chithigun23/ANUFS-Telemetry/active_antenna_addition_BOM.md

# Active Antenna Addition — Planning Doc

Status: **implemented in schematic** (telemetry.kicad_sch), now covering two features:
1. The original single-antenna active bias-tee on J2 (below).
2. A second GNSS module + antenna (U15/J8) added purely for **heading**, via dual-antenna
   moving-base RTK — see "Dual-antenna heading addition" further down.

Library symbols/footprints for the new parts (LQW15AN56NG00D, PESD0402-140, DMG2305UX-7)
exist in telemetry-library, though the FET ended up unused — see below.

Goal, as built: dedicated active-antenna bias-tee on the existing SMA connector (J2), always
on (no switch — see "Design history" for why the switch was dropped, and why passive-antenna
compatibility is no longer a design goal: precise RTK positioning needs the active antenna's
phase-center stability and multipath rejection, so this connector is active-only going forward).

## Design history (superseded — kept for context)

Originally planned as two separate SMA connectors (existing J2 for passive, a new J601 for
active) selected by an RF switch (pSemi PE4259), so both antennas could be mounted
simultaneously with instant electronic selection. **Dropped this approach**: it only makes
sense if both antennas need to be physically connected at once.

Next iteration was a single connector supporting *either* antenna type, with bias switchable
via a FET (Q601/Q602/R602) so bias could be disabled for passive-antenna safety or power
saving. **Also dropped, for two reasons:**
1. Checked whether the module itself gates VDD_RF based on `ANT_ON` — it doesn't. VDD_RF just
   mirrors VCC always. And on this board, VCC is never power-cycled and `WAKEUP` is
   unconnected (no path to exit Backup mode), so the module never leaves Continuous mode in
   the first place — there's no power-saving event for a switch to respond to.
2. The actual goal is RTK positioning as close to 1cm as achievable. That needs the active
   antenna's phase-center stability and multipath rejection — a passive antenna is a strictly
   worse choice for this application, not a fallback worth keeping wired in. So "safely
   support either antenna type" stopped being a real requirement, and with it, the reason to
   worry about a passive antenna's DC-short fault mode on this connector went away too.

Net result: **no switch, active-only, bias always on.** `R601` (10Ω, in series with the bias
feed) still exists and still matters — it protects the module if the antenna connector is ever
shorted (e.g. a wiring fault, connector mishap), which is a real scenario worth guarding
against regardless of antenna type.

## Active antenna

**u-blox ANN-MB1-00**
- Dual-band: L1 (1559–1606 MHz) + L5/E5a/B2a/NavIC (1164–1188 MHz) — matches LC29H(EA)'s
  dual-band capability
- Bias: 3.0–5.0 V, typ. 15 mA @ 5V (VDD_RF on this board mirrors VCC = 3.3V, within spec)
- LNA gain: typ. 29 dB (L1) / 33 dB (L5), pre-filtered with an internal SAW
- 5 m RG174 cable, SMA connector, magnetic mount
- IP67, –40°C to +85°C, CE approved
- Source: [DigiKey](https://www.digikey.com/en/products/detail/u-blox/ANN-MB1-00/14835875)
- Datasheet: [ANN-MB1 Product Summary](https://content.u-blox.com/sites/default/files/ANN-MB1_ProductSummary_UBX-21000238.pdf)

## Topology (as built)

Follows Quectel's own active-antenna reference circuit (Hardware Design doc, Sheet 6), minus
the optional power switch. `VDD_RF → R40 → [C36, C38 decoupling] → L2 → antenna node [D2 TVS,
J2, C40 DC-block] → RF_IN`. Bias is always on.

| Schematic ref | Part | Value/Footprint | Connects |
|---|---|---|---|
| R40 | 10Ω | [Resistor_SMD:R_0402_1005Metric_Pad0.72x0.64mm_HandSolder](.) | VDD_RF (pin 9) → bias choke; limits fault current if the connector is ever shorted |
| C36 | Yageo CC0402KRX7R7BB104, 100nF, X7R | [LCSC C60474](https://www.lcsc.com/product-detail/C60474.html), 16V, ±10%, $0.005 (100+ qty) | Decouple, on bias line near L2 — shunt-to-ground, dielectric loss doesn't matter here |
| C38 | Yageo CC0402JRNPO9BN101, 100pF, C0G/NP0 | [LCSC C106200](https://www.lcsc.com/product-detail/Multilayer-Ceramic-Capacitors-MLCC-SMD-SMT_YAGEO-CC0402JRNPO9BN101_C106200.html), 50V, ±5%, $0.0044 (100+ qty) | Decouple, on bias line near L2 |
| L2 | Murata LQW15AN56NG00D, 56nH | telemetry:LQW15AN56NG00D, [DigiKey 490-6830-1-ND](https://www.digikey.com/en/products/detail/murata-electronics/LQW15AN56NG00D/3846027) | Feeds DC bias onto the RF_IN line without loading the RF signal. SRF 2.8GHz (56% margin above L1's 1575.42MHz — chosen over Quectel's literal 68nH spec, which only has ~3% SRF margin on any commonly available part), 200mA rating, $0.12 |
| D2 | Littelfuse PESD0402-140 | telemetry:PESD0402-140, [DigiKey PESD0402-140CT-ND](https://www.digikey.com/en/products/detail/littelfuse-inc/PESD0402-140/1968525) | ESD protection at the antenna node. 0.05pF (well under Quectel's <0.6pF recommendation), 14V standoff (clear of the 3.3V bias), $0.80 |
| C40 | Yageo CC0402JRNPO9BN101, 100pF, C0G/NP0 | [LCSC C106200](https://www.lcsc.com/product-detail/Multilayer-Ceramic-Capacitors-MLCC-SMD-SMT_YAGEO-CC0402JRNPO9BN101_C106200.html), 50V, ±5%, $0.0044 (100+ qty) | DC block between the antenna node and RF_IN (pin 11) — C0G/NP0 specifically chosen since this cap sits directly in the RF signal path (X7R's higher dielectric loss would add real insertion loss here, unlike C36 which is just a shunt bypass) |
| J2 | (existing) | — | Antenna connector, SMA |

**Dielectric note:** C38 and C40 use the *same* C0G/NP0 part (LCSC C106200) even though C38 is just a decoupling cap that didn't strictly need C0G — no cost or sourcing penalty at this value, and it simplifies the BOM to one fewer distinct part. C36 stays X7R since 100nF isn't practically available in C0G at 0402 size, and it doesn't matter for a shunt-to-ground bypass cap anyway.

**Note:** `R40`'s footprint was originally set to `Resistor_THT:R_Array_SIP4` (wrong package,
clearly a leftover default) and `C36`/`C38`/`C40` had no footprint at all — all four fixed
directly in the schematic (2026-09-18).

**Sourcing note:** AEC-Q200 was not treated as a requirement when picking L2/D2 —
for a Formula Student car (rebuilt/inspected each season, not a 10+ year OEM warranty part),
the real drivers are electrical fit and physical robustness (temp range, small rigid SMD
construction), not automotive PPAP qualification. Both parts are confirmed direct
DigiKey stock, not DigiKey Marketplace listings.

**Not used: Diodes Inc DMG2305UX-7 P-FET.** A symbol/footprint (`telemetry:DMG2305UX-7`)
exists in the library from when a bias switch was still planned, but the switch was dropped
(see Design history) before it got used anywhere in the schematic. The board does have an
unrelated `Q1` (DMP3099LQ-7) and `Q2` (MMBT3904) — those belong to a separate 12V input
protection circuit, not this antenna feature; don't confuse the two when reading the BOM.

## Dual-antenna heading addition (U15/J8) — implemented in schematic

**Why:** the AUSCORS/CORSnet-NSW network corrections (free, via Geoscience Australia's
Positioning Australia program) improve absolute *position* accuracy, but say nothing about
which way the car is pointing. A single antenna's only heading signal is course-over-ground
(the direction of the velocity vector), which is meaningless at low speed or standstill. True,
speed-independent heading needs a second antenna at a fixed, known separation, computed via
moving-base RTK between two receivers — a completely separate feature from the network RTK
corrections, not a replacement for them. Both can be used at once if wanted.

**Roles:**
- **U13 (existing module) = Rover.** Unchanged — still talks to the MCU exactly as before
  (UART1 → level shifter U14 → STM32 **UART4**, AF8, on PA0/PA1). It's the one that outputs
  the final position/heading solution.
- **U15 (new module) = Base.** Only generates the raw observation stream for U13 to compute
  the baseline/heading against. Does **not** talk to the MCU at all — U15's own UART1
  (TXD1/RXD1) and 1PPS (pin 3) are intentionally NC-flagged, unused.

**Module-to-module link (UART2 on both modules, full crossover, no level shifting needed —
both run off their own internally-generated VDD_EXT at the same logic level):**
| From | To | Net |
|---|---|---|
| U15 (Base) TXD2, pin 15 | U13 (Rover) RXD2, pin 16 | `TXD2_GNSS_2V8_2` |
| U13 (Rover) TXD2, pin 15 | U15 (Base) RXD2, pin 16 | `RXD2_GNSS_2V8_2` |

**Second bias-tee (U15), identical topology to J2's, same parts reused:**
`VDD_RF (U15 pin 9) → R41 → [C41, C43 decoupling] → L3 → antenna node [D5 TVS, J8, C42
DC-block] → RF_IN (U15 pin 11)`

| Schematic ref | Part | Value/Footprint | Connects |
|---|---|---|---|
| R41 | 10Ω | Resistor_SMD:R_0402_1005Metric_Pad0.72x0.64mm_HandSolder | VDD_RF → bias choke, same fault-current role as R40 |
| C41 | Yageo, 100pF, C0G/NP0 | [LCSC C106200](https://www.lcsc.com/product-detail/Multilayer-Ceramic-Capacitors-MLCC-SMD-SMT_YAGEO-CC0402JRNPO9BN101_C106200.html) | Decouple, bias line near L3 |
| C43 | Yageo CC0402KRX7R7BB104, 100nF, X7R | [LCSC C60474](https://www.lcsc.com/product-detail/C60474.html) | Decouple, bias line near L3 |
| L3 | Murata LQW15AN56NG00D, 56nH | telemetry:LQW15AN56NG00D, [DigiKey 490-6830-1-ND](https://www.digikey.com/en/products/detail/murata-electronics/LQW15AN56NG00D/3846027) | Same SRF-margin choke as L2 |
| D5 | Littelfuse PESD0402-140 | telemetry:PESD0402-140, [DigiKey PESD0402-140CT-ND](https://www.digikey.com/en/products/detail/littelfuse-inc/PESD0402-140/1968525) | ESD protection at antenna node |
| C42 | Yageo CC0402JRNPO9BN101, 100pF, C0G/NP0 | [LCSC C106200](https://www.lcsc.com/product-detail/Multilayer-Ceramic-Capacitors-MLCC-SMD-SMT_YAGEO-CC0402JRNPO9BN101_C106200.html) | DC block, antenna node → RF_IN |
| J8 | GCT RFPC-SMA27-F | telemetry:RFPC-SMA27-F, [DigiKey 22162144](https://www.digikey.com/en/products/detail/gct/RFPC-SMA27-F/22162144), right-angle THT SMA jack, 6GHz, ~$2.26 — same part as J2. **Currently backorder/out of stock at DigiKey**, worth checking before final BOM lock | Second antenna connector |

All of R41/C41/C43/L3/D5/C42 are the exact same MPNs as R40/C36/C38/L2/D2/C40 (module 1) —
just a second set, no new sourcing decisions needed for those. J8 is the only genuinely new
line item.

**D_SEL pull-ups (U15):** R42 (39kΩ, DSEL2 → `VDD_EXT_2`) and R43 (39kΩ, DSEL1 → `VDD_EXT_2`)
— same 39kΩ-to-VDD_EXT strapping as U13's R38/R39, giving D_SEL=(1,0)=SPI... actually giving
whatever mode U13 uses; set to match U13's strap so both modules are configured identically.

**Level shifter U16 — added, then removed.** Originally duplicated U14 alongside U15 to give
it its own MCU-facing level-shifted UART1, but that's unnecessary: U15 never talks to the MCU
in this design, so there's nothing for a second level shifter to shift. Removed, along with
its supporting R46/C44 (which existed to support U16 specifically, same as R35/C23 support
U14 — not independent parts, correctly deleted together).

**Shared reset:** U13 and U15 are tied to the same `GNSS_RESET_N` net — both modules reset
together off one MCU line. Intentional/simplest choice; revisit only if independent resets
are ever needed (e.g. power-cycling just the Base without disturbing the Rover).

**Second antenna:** same u-blox ANN-MB1-00 as the first (see "Active antenna" section above)
— need **two** of this part now, not one. Minimum antenna separation for reliable RTK-Fixed
heading is realistically ~30cm+ (Quectel's documented minimum is 0.2m, but field reports
suggest 27cm baselines only reach RTK-Float, not Fixed) — mounting separation on the car needs
to account for this.

**Firmware TODO (not yet done, flagging so it isn't forgotten):**
- Configure U15 (Base) to output raw observation data on UART2 (moving-base mode).
- Configure U13 (Rover) to accept corrections on UART2 and enable `PQTMTAR` output
  (baseline distance + heading) at a sane rate — 10Hz has been reported to give worse
  RTK-Fixed stability than 1–5Hz in the field, worth testing both.
- STM32 side is unchanged — still just UART4 (AF8) on PA0/PA1 reading U13's NMEA/PQTM output,
  exactly as the single-antenna design already required.

## Bandpass filtering — decided against, not implementing

Considered adding a board-level bandpass filter for automotive EMI robustness (Quectel's
reference design marks this optional). **Decision: not using an external bandpass filter.**
The single-connector switchable-bias feature above stands on its own without it.

Research is kept below for reference in case this gets revisited later — e.g. if EMI proves
to be a real problem once the car is running and generating RF noise on track.

<details>
<summary>Bandpass filter research (not currently planned)</summary>

LC29H(EA) has a single dual-band `RF_IN` pin (no separate L1/L2 inputs), so what would be
needed is a filter that passes *both* L1 and L5 on one line while rejecting everything else.

**Rejected option — Taoglas DXP.02.A SAW diplexer used as a combiner.** Considered splitting
the antenna signal 2 ways, feeding one leg into the diplexer's L1 port and the other into its
L2/L5 port, and taking the recombined signal off Common. **Do not use this** — a diplexer's
ports are only 50Ω-matched *within that port's own passband*; band separation works by
reflecting out-of-band energy, not absorbing it. Feeding a dual-band signal into a single-band
port means the other band's energy hits an uncharacterized, reflective mismatch at that port.
Combined with ~3dB splitter loss and ~4dB diplexer loss, this is not a clean 50Ω system.

**If revisited, use instead — Abracon AFII-LC-0081 full-band GNSS ceramic bandpass filter:**
- Genuine 2-port device (Input/Output), not a diplexer
- 50Ω source and load impedance, both ports — datasheet states "a matching network is
  unnecessary." VSWR 1.2 typ / 1.5 max across the entire 1125–1675 MHz passband, so both L1
  and L5 sit cleanly inside one continuous, well-matched band
- Insertion loss: 0.85dB typ / 1.9dB max
- Rejection: 40dB below 900MHz, 25dB at 900-1002MHz, 35dB at 2-2.5GHz, 27dB at 2.5-5.95GHz
- Has internal DC-blocking caps on both input/output — would need to sit upstream of the
  bias-injection point on the active leg
- 3.2×2.5×1.75mm SMD, -45°C to +85°C, MSL1, automotive-validated COTS per Abracon's datasheet
- ~$0.76. [DigiKey (AFII-LC-0081-T)](https://www.digikey.com/en/products/detail/abracon-llc/AFII-LC-0081-T/) · [Datasheet](https://abracon.com/datasheets/AFII-LC-0081.pdf)

</details>
