chithigun23/ANUFS-Telemetry/hardware/TELEMETRY_DigiKey_BOM.xlsx

Sheet: BOM
# | Reference(s) | Qty | Value | Package / Footprint | Manufacturer | Manufacturer Part Number (MPN) | DigiKey Part Number | Purchasing spec / action | Notes
1 | C1,C14,C19-C21,C24-C26,C32-C37,C43,C46 | 16 | 100nF | C_0402_1005Metric_Pad0.74x0.62mm_HandSolder |  |  |  | Select exact supplier part matching value and footprint.
2 | C2,C11-C13,C17,C41,C44,C47,C53 | 9 | 1uF | C_0402_1005Metric_Pad0.74x0.62mm_HandSolder |  |  |  | Select exact supplier part matching value and footprint.
3 | C3 | 1 | 220nF | C_0402_1005Metric_Pad0.74x0.62mm_HandSolder |  |  |  | Select exact supplier part matching value and footprint.
4 | C4,C10,C38-C40,C42,C45 | 7 | 10uF | C_0402_1005Metric_Pad0.74x0.62mm_HandSolder |  |  |  | Select exact supplier part matching value and footprint.
5 | C5,C7-C9,C18 | 5 | 22uF | C_0402_1005Metric_Pad0.74x0.62mm_HandSolder |  |  |  | Select exact supplier part matching value and footprint.
6 | C6 | 1 | 100uF | CP_Elec_6.3x7.7 |  |  |  | Select exact supplier part matching value and footprint.
7 | C15,C16 | 2 | 8pF | C_0402_1005Metric_Pad0.74x0.62mm_HandSolder |  |  |  | Select exact supplier part matching value and footprint.
8 | C22,C23 | 2 | 2.2uF | C_0402_1005Metric_Pad0.74x0.62mm_HandSolder |  |  |  | Select exact supplier part matching value and footprint.
9 | C27,C30,C48,C51 | 4 | 100pF | C_0402_1005Metric_Pad0.74x0.62mm_HandSolder | Yageo | CC0402JRNPO9BN101 |  | Match package and ordering suffix. | LCSC: C106200. C0G/NP0, 50V, 5%. GNSS antenna bias-tee DC block or bias decoupling cap (source: active_antenna_addition_BOM.md).
10 | C31,C52 | 2 | 100nF | C_0402_1005Metric_Pad0.74x0.62mm_HandSolder | Yageo | CC0402KRX7R7BB104 |  | Match package and ordering suffix. | LCSC: C60474. X7R, 16V, 10%. GNSS antenna bias-tee decoupling cap (source: active_antenna_addition_BOM.md).
11 | D1 | 1 | BZT52-C15S-AU_R1_000A1 | D_SOD-123 |  | BZT52-C15S-AU_R1_000A1 |  | Match package and ordering suffix. | Part identifier from schematic value; verify exact ordering code.
12 | D2 | 1 | SMBJ16A | SMBJ16A | Littelfuse | SMBJ16A |  | Match package and ordering suffix. | LCSC: C151254
13 | D3 | 1 | PMEG2010BER | Nexperia_CFP3_SOD-123W |  | PMEG2010BER |  | Match package and ordering suffix. | Part identifier from schematic value; verify exact ordering code.
14 | D4,D5 | 2 | PESD0402-140 | PESD0402-140 | Littelfuse | PESD0402-140 | PESD0402-140CT-ND | Match package and ordering suffix. | LCSC: C10662. ESD protection at the GNSS antenna node.
15 | F1 | 1 | 1.5A Polyfuse | L_1812_4532Metric_Pad1.30x3.40mm_HandSolder |  |  |  | Select exact supplier part matching value and footprint.
16 | J1,J4,J5 | 3 | 2601-1102 | WAGO-2601-1102 |  |  |  | Select exact supplier part matching value and footprint.
17 | J3,J11 | 2 | MOLEX_104031-0811 | MOLEX_104031-0811 |  |  |  | Select exact supplier part matching value and footprint.
18 | J6 | 1 | USB_C_Receptacle_USB2.0_16P | USB-C-SMD_TYPE-C-16PIN-2MD-073 |  |  |  | Select exact supplier part matching value and footprint. | LCSC: C2765186
19 | J7-J10 | 4 | RFPC-SMA27-F | RFPC-SMA27-F | GradConn | RFPC-SMA27-F |  | Match package and ordering suffix. | J7 and J8 are the GNSS antenna inputs. J9 and J10 are joined to each other on net ANT3 (RF test through-path). active_antenna_addition_BOM.md lists this part as GCT, DigiKey 22162144, and flags it as backorder: check stock before ordering.
20 | L1 | 1 | 8uH, 14m | L_TaiTech_TMPC1265_13.5x12.5mm |  |  |  | Select exact supplier part matching value and footprint.
21 | L2,L3 | 2 | LQW15AN56NG00D | LQW15AN56NG00D | Murata | LQW15AN56NG00D | 490-6830-1-ND | Match package and ordering suffix. | LCSC: C167482. 56nH GNSS antenna bias choke, SRF 2.8GHz (source: active_antenna_addition_BOM.md).
22 | LED1-LED5 | 5 | XL-2012SURUGC | XL-2012SURUGC | XINGLIGHT(成兴光) | XL-2012SURUGC |  | Match package and ordering suffix. | LCSC: C965845
23 | Q1 | 1 | DMP3099LQ-7 | SOT-23 |  | DMP3099LQ-7 |  | Match package and ordering suffix. | Part identifier from schematic value; verify exact ordering code.
24 | Q2 | 1 | MMBT3904 | SOT-23 |  | MMBT3904 |  | Match package and ordering suffix. | Part identifier from schematic value; verify exact ordering code.
25 | R1 | 1 | 23.7k | R_0402_1005Metric_Pad0.72x0.64mm_HandSolder |  |  |  | Select exact supplier part matching value and footprint.
26 | R2 | 1 | 18.2k | R_0402_1005Metric_Pad0.72x0.64mm_HandSolder |  |  |  | Select exact supplier part matching value and footprint.
27 | R3 | 1 | 21.5k | R_0402_1005Metric_Pad0.72x0.64mm_HandSolder |  |  |  | Select exact supplier part matching value and footprint.
28 | R4,R38 | 2 | 100k | R_0402_1005Metric_Pad0.72x0.64mm_HandSolder |  |  |  | Select exact supplier part matching value and footprint.
29 | R5,R6,R11,R12 | 4 | 5k | R_0402_1005Metric_Pad0.72x0.64mm_HandSolder |  |  |  | Select exact supplier part matching value and footprint.
30 | R7,R13-R23,R26-R29,R34,R36,R37,R46-R52 | 26 | 10k | R_0402_1005Metric_Pad0.72x0.64mm_HandSolder |  |  |  | Select exact supplier part matching value and footprint.
31 | R8 | 1 | 43.2k | R_0402_1005Metric_Pad0.72x0.64mm_HandSolder |  |  |  | Select exact supplier part matching value and footprint.
32 | R9 | 1 | 10.2k | R_0402_1005Metric_Pad0.72x0.64mm_HandSolder |  |  |  | Select exact supplier part matching value and footprint.
33 | R10 | 1 | 73.2k | R_0402_1005Metric_Pad0.72x0.64mm_HandSolder |  |  |  | Select exact supplier part matching value and footprint. | 73.2k sets the TPS2121 OV1 trip. Trip = VREF x (1 + R10/R12) with VREF 1.01/1.06/1.10 V (min/typ/max, TPS2121 datasheet) and R12 = 5k: 15.8/16.6/17.2 V, above the ~14 V vehicle supply maximum (TEL-28).
34 | R24,R25 | 2 | 4.7k | R_0402_1005Metric_Pad0.72x0.64mm_HandSolder |  |  |  | Select exact supplier part matching value and footprint.
35 | R30,R31 | 2 | 1.87k | R_0402_1005Metric_Pad0.72x0.64mm_HandSolder |  |  |  | Select exact supplier part matching value and footprint.
36 | R32,R33 | 2 | 5.1k | R_0402_1005Metric_Pad0.72x0.64mm_HandSolder |  |  |  | Select exact supplier part matching value and footprint.
37 | R35,R42 | 2 | 0 | R_0402_1005Metric_Pad0.72x0.64mm_HandSolder |  |  |  | Select exact supplier part matching value and footprint. | 0 ohm link in the RF pi-filter series position, populated.
38 | R39,R43 | 2 | 10 | R_0402_1005Metric_Pad0.72x0.64mm_HandSolder |  |  |  | Select exact supplier part matching value and footprint. | GNSS antenna bias series resistor, limits fault current if the antenna connector is shorted (source: active_antenna_addition_BOM.md).
39 | SW1,SW2 | 2 | CJS-1200TB1 | CJS-1200TB1 | Nidec Components | CJS-1200TB1 |  | Match package and ordering suffix. | LCSC: C2921631
40 | SW3 | 1 | SW_NRST | SMD-Switch |  |  |  | Select exact supplier part matching value and footprint.
41 | SW4 | 1 | SW_BOOT0 | SMD-Switch |  |  |  | Select exact supplier part matching value and footprint.
42 | TP1 | 1 | VBUS | TestPoint_THTPad_D2.0mm_Drill1.0mm |  |  |  | Optional physical test point; select matching footprint.
43 | TP2 | 1 | +3V3 | TestPoint_THTPad_D2.0mm_Drill1.0mm |  |  |  | Optional physical test point; select matching footprint.
44 | TP3 | 1 | PG_BUCK | TestPoint_THTPad_D2.0mm_Drill1.0mm |  |  |  | Optional physical test point; select matching footprint.
45 | TP4 | 1 | GND | TestPoint_THTPad_D2.0mm_Drill1.0mm |  |  |  | Optional physical test point; select matching footprint.
46 | TP5 | 1 | CAN1+ | TestPoint_THTPad_D2.0mm_Drill1.0mm |  |  |  | Optional physical test point; select matching footprint.
47 | TP6 | 1 | CAN1- | TestPoint_THTPad_D2.0mm_Drill1.0mm |  |  |  | Optional physical test point; select matching footprint.
48 | TP7 | 1 | CAN2+ | TestPoint_THTPad_D2.0mm_Drill1.0mm |  |  |  | Optional physical test point; select matching footprint.
49 | TP8 | 1 | CAN2- | TestPoint_THTPad_D2.0mm_Drill1.0mm |  |  |  | Optional physical test point; select matching footprint.
50 | U1 | 1 | LMR33610ADDAR | Texas_HSOP-8-1EP_3.9x4.9mm_P1.27mm_ThermalVias |  | LMR33610ADDAR |  | Match package and ordering suffix. | Part identifier from schematic value; verify exact ordering code.
51 | U2 | 1 | TPS2121RUXR | VQFN-HR-12_L2.5-W2.0-P0.50-BL | TI(德州仪器) | TPS2121RUXR |  | Match package and ordering suffix. | LCSC: C485916
52 | U3 | 1 | ASM330LHHXG1TR | ASM330LHHXG1TR |  | ASM330LHHXG1TR |  | Match package and ordering suffix. | PCB value now matches the schematic (ASM330LHHXG1TR).
53 | U4,U7 | 2 | TCAN337 | SOIC-8_3.9x4.9mm_P1.27mm |  | TCAN337 |  | Match package and ordering suffix. | Part identifier from schematic value; verify exact ordering code.
54 | U5 | 1 | LM2940CT-5.0/LF01 | TO-263-3_TabPin2 (SMD formed-lead, TI NDG) | Texas Instruments | LM2940CT-5.0/LF01 |  | Match package and ordering suffix. | Confirmed SMD formed-lead variant (TI package code NDG) -- entire part incl. tab solders flat to the board, no through-hole leads and no mounting screw. Do not substitute the standard through-hole TO-220 LM2940CT-5.0/NOPB.
55 | U6 | 1 | STM32H523RCT7 | STM32H523RCT7 |  | STM32H523RCT7 |  | Match package and ordering suffix. | Part identifier from schematic value; verify exact ordering code.
56 | U8,U9 | 2 | TLC59108IPWR | TLC59108IPWR | Texas Instruments | TLC59108IPWR |  | Match package and ordering suffix.
57 | U10,U13 | 2 | LC29HEAMD | LC29HEAMD | Quectel | LC29HEAMD |  | Match package and ordering suffix. | U10 is the moving base (talks to the MCU), U13 is the rover. Part identifier from schematic value; verify exact ordering code.
58 | U11 | 1 | USBLC6-2SC6 | SOT-23-6 |  | USBLC6-2SC6 |  | Match package and ordering suffix. | Part identifier from schematic value; verify exact ordering code.
59 | U12 | 1 | TXS0104EPW | TSSOP-14_4.4x5mm_P0.65mm |  | TXS0104EPW |  | Match package and ordering suffix. | Part identifier from schematic value; verify exact ordering code.
60 | Y1 | 1 | ABM8AIG-24.000MHz-8-2Z-T | ABM8AIG-24.000MHZ-8-2Z-T | Abracon | ABM8AIG-24.000MHz-8-2Z-T |  | Match package and ordering suffix. | Part identifier from schematic value; verify exact ordering code.
 | TOTAL PLACEMENTS
 | NOT PURCHASED: DNP or excluded from BOM (listed for reference, not in the total above)
 | C28,C29,C49,C50 | 4 | 0 | C_0402_1005Metric_Pad0.74x0.62mm_HandSolder |  |  |  | Do not order. | DNP: RF pi-filter shunt pad, intentionally left empty (tuning allowance)
 | H1-H4 | 4 | MountingHole_Pad | MountingHole_3.2mm_M3_Pad |  |  |  | Do not order. | Mounting hole, not purchased
 | J2 | 1 | TC2030 | Tag-Connect_TC2030-IDC-FP_2x03_P1.27mm_Vertical |  |  |  | Do not order. | Tag-Connect TC2030 footprint only, no part to buy (excluded from BOM in schematic)
 | J12 | 1 | Conn_01x04 | PinHeader_1x04_P2.54mm_Vertical |  |  |  | Do not order. | DNP: alternative 1x4 SWD header, only one of J2 / J12 is ever fitted (excluded from BOM in schematic)

Sheet: Cautions
Item | Severity | What it is | What to do before / when ordering
R10 (TEL-28) | CHECK | TPS2121 OV1 divider R10/R12 sets the vehicle-input overvoltage trip. With R10 = 73.2k and R12 = 5k the trip is 15.8/16.6/17.2 V (min/typ/max, VREF 1.01/1.06/1.10 V). | Fit 73.2k at R10, matching the schematic and PCB (a 1% part keeps the trip window tight). An older BOM carried a lower value that trips inside the vehicle supply range, so do not reuse parts bought from it.
Supplier selection | TO COMPLETE | Rows without an exact MPN require part selection. | Use the value, footprint and listed specifications. Blank DigiKey numbers have not been sourced.
DigiKey Upload | SCOPE | Only explicit schematic MPNs and non-inferred existing BOM MPNs are included. | Resolve rows with missing or inferred part numbers on the BOM before adding them to an order.
Quantity basis | INFO | 149 BOM-included board items; one board. | Excludes: H1, H2, H3, H4, J2, J12 (excluded from BOM in the schematic) and C28, C29, C49, C50 (DNP RF pad positions, intentionally empty). Optional test points and bare wire pads may not require purchased parts.
Source | INFO | hardware/telemetry.net exported 2026-10-13 (Eeschema 10.0.6), matching schematic and PCB. | Quantities and footprints use the netlist. Part metadata uses the schematic fields, with antenna-circuit parts from active_antenna_addition_BOM.md.

Sheet: DigiKey Upload
Manufacturer Part Number | Quantity | Customer Reference
SMBJ16A | 1 | D2
XL-2012SURUGC | 5 | LED1-LED5
CJS-1200TB1 | 2 | SW1,SW2
TPS2121RUXR | 1 | U2
LM2940CT-5.0/LF01 | 1 | U5
TLC59108IPWR | 2 | U8,U9
LQW15AN56NG00D | 2 | L2,L3
PESD0402-140 | 2 | D4,D5
Only source-specified MPNs are listed. Complete missing or inferred part numbers on the BOM before ordering.
