chithigun23/ANUFS-Telemetry/telemetry-library/3d/ASM330LHHXG1TR.step

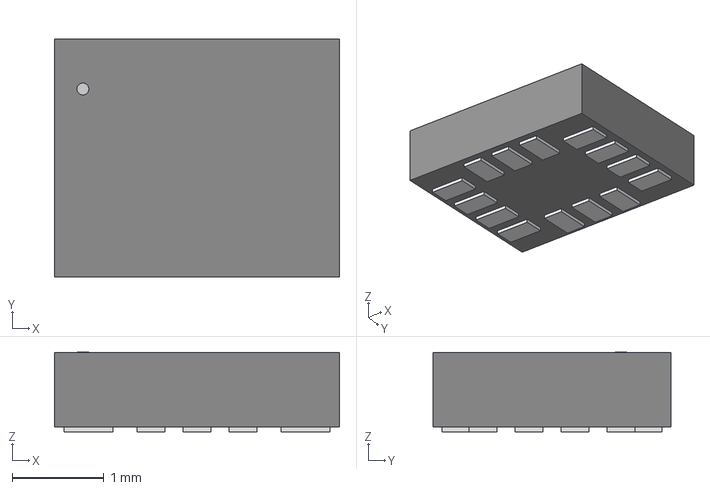
[picture p1: CAD file, 2026-08-07]
telemetry-library/3d/ASM330LHHXG1TR.step
3.10 x 2.59 x 0.866 mm
