chithigun23/ANUFS-Telemetry/telemetry-kicad/telemetry-library/3d/SD_Yamaichi_FPS009-4200-0.step

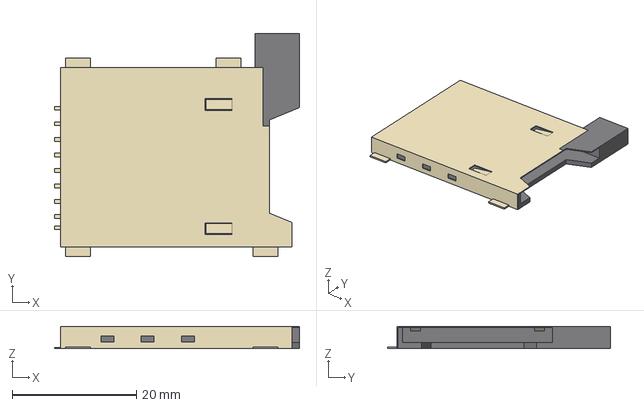
[picture p2: CAD file, 2026-09-14]
telemetry-kicad/telemetry-library/3d/SD_Yamaichi_FPS009-4200-0.step
39.5 x 35.9 x 3.60 mm
