chithigun23/ANUFS-Telemetry/telemetry-library/3d/SMD-Switch.step

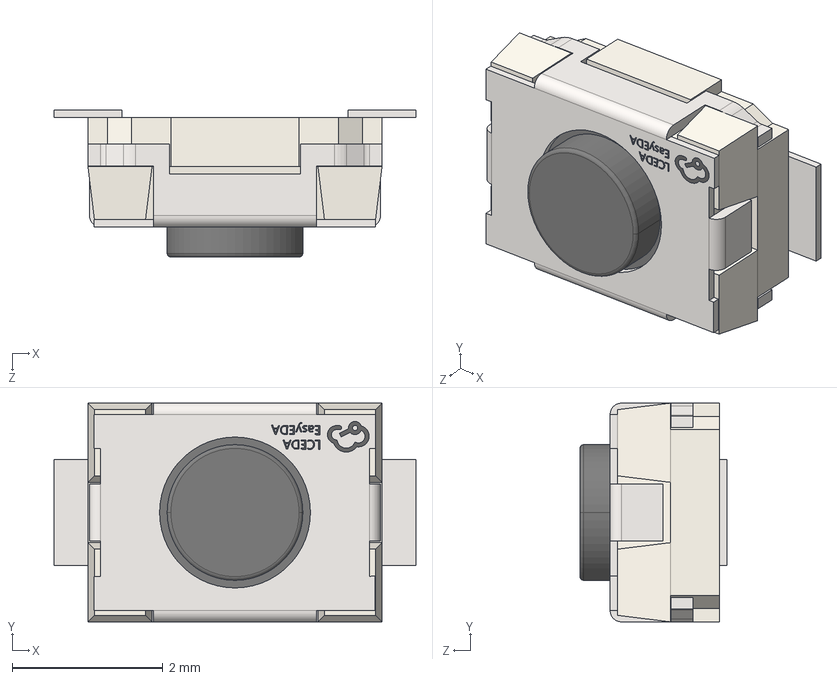
[picture p3: CAD file, 2026-08-09]
telemetry-library/3d/SMD-Switch.step
4.80 x 2.90 x 1.95 mm
