chithigun23/ANUFS-Telemetry/telemetry-kicad/telemetry-library/3d/MOLEX_104031-0811.stp

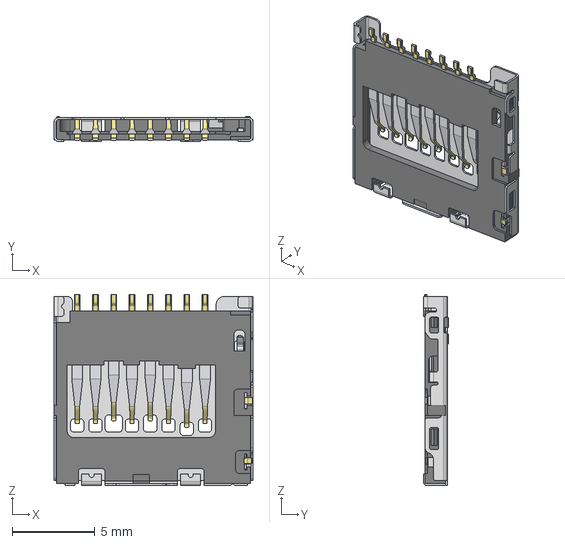
[picture p4: CAD file, 2026-09-14]
telemetry-kicad/telemetry-library/3d/MOLEX_104031-0811.stp
12.0 x 1.53 x 11.5 mm
