chithigun23/ANUFS-Telemetry/telemetry-library/3d/TCAN1044VDRQ1.stp

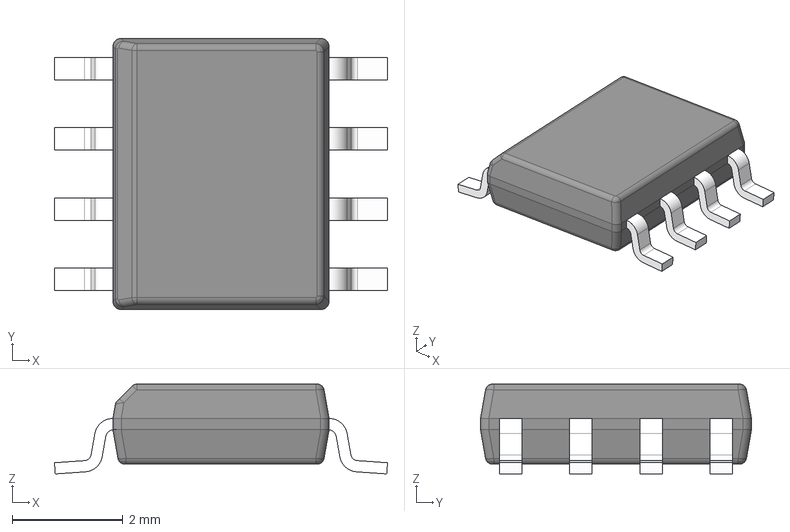
[picture p5: CAD file, 2026-08-07]
telemetry-library/3d/TCAN1044VDRQ1.stp
6.02 x 4.90 x 1.63 mm
BODY-SO
LEAD-D0008A x 8
