chithigun23/ANUFS-Telemetry/telemetry-kicad/telemetry-library/3d/STM32H523RCT7.step

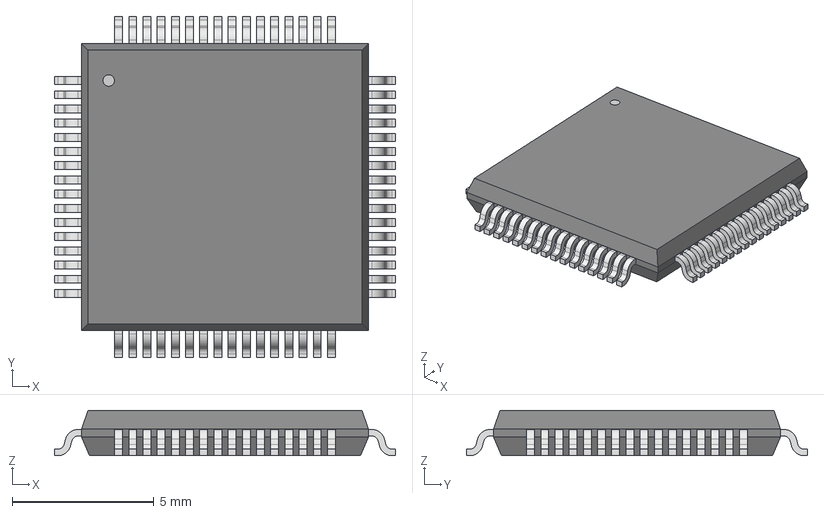
[picture p6: CAD file, 2026-08-09]
telemetry-kicad/telemetry-library/3d/STM32H523RCT7.step
12.0 x 12.0 x 1.60 mm
