chithigun23/ANUFS-Telemetry/telemetry-library/3d/MAX-M10S-00B.step

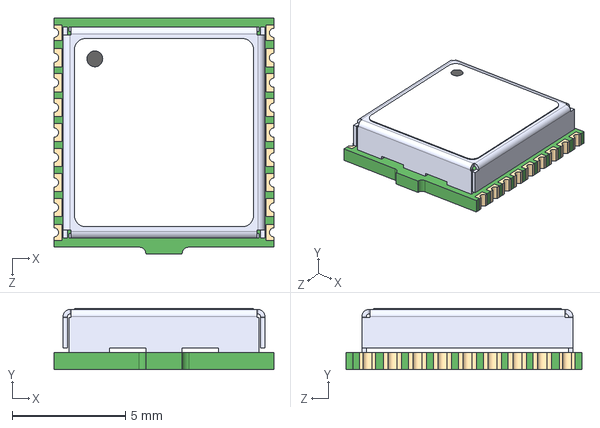
[picture p7: CAD file, 2026-08-06]
telemetry-library/3d/MAX-M10S-00B.step
9.70 x 2.70 x 10.4 mm
