chithigun23/ANUFS-Telemetry/hardware/telemetry-kicad/telemetry.kicad_pcb

## KiCad design hardware/telemetry-kicad/telemetry.kicad_pcb (2026-10-27)

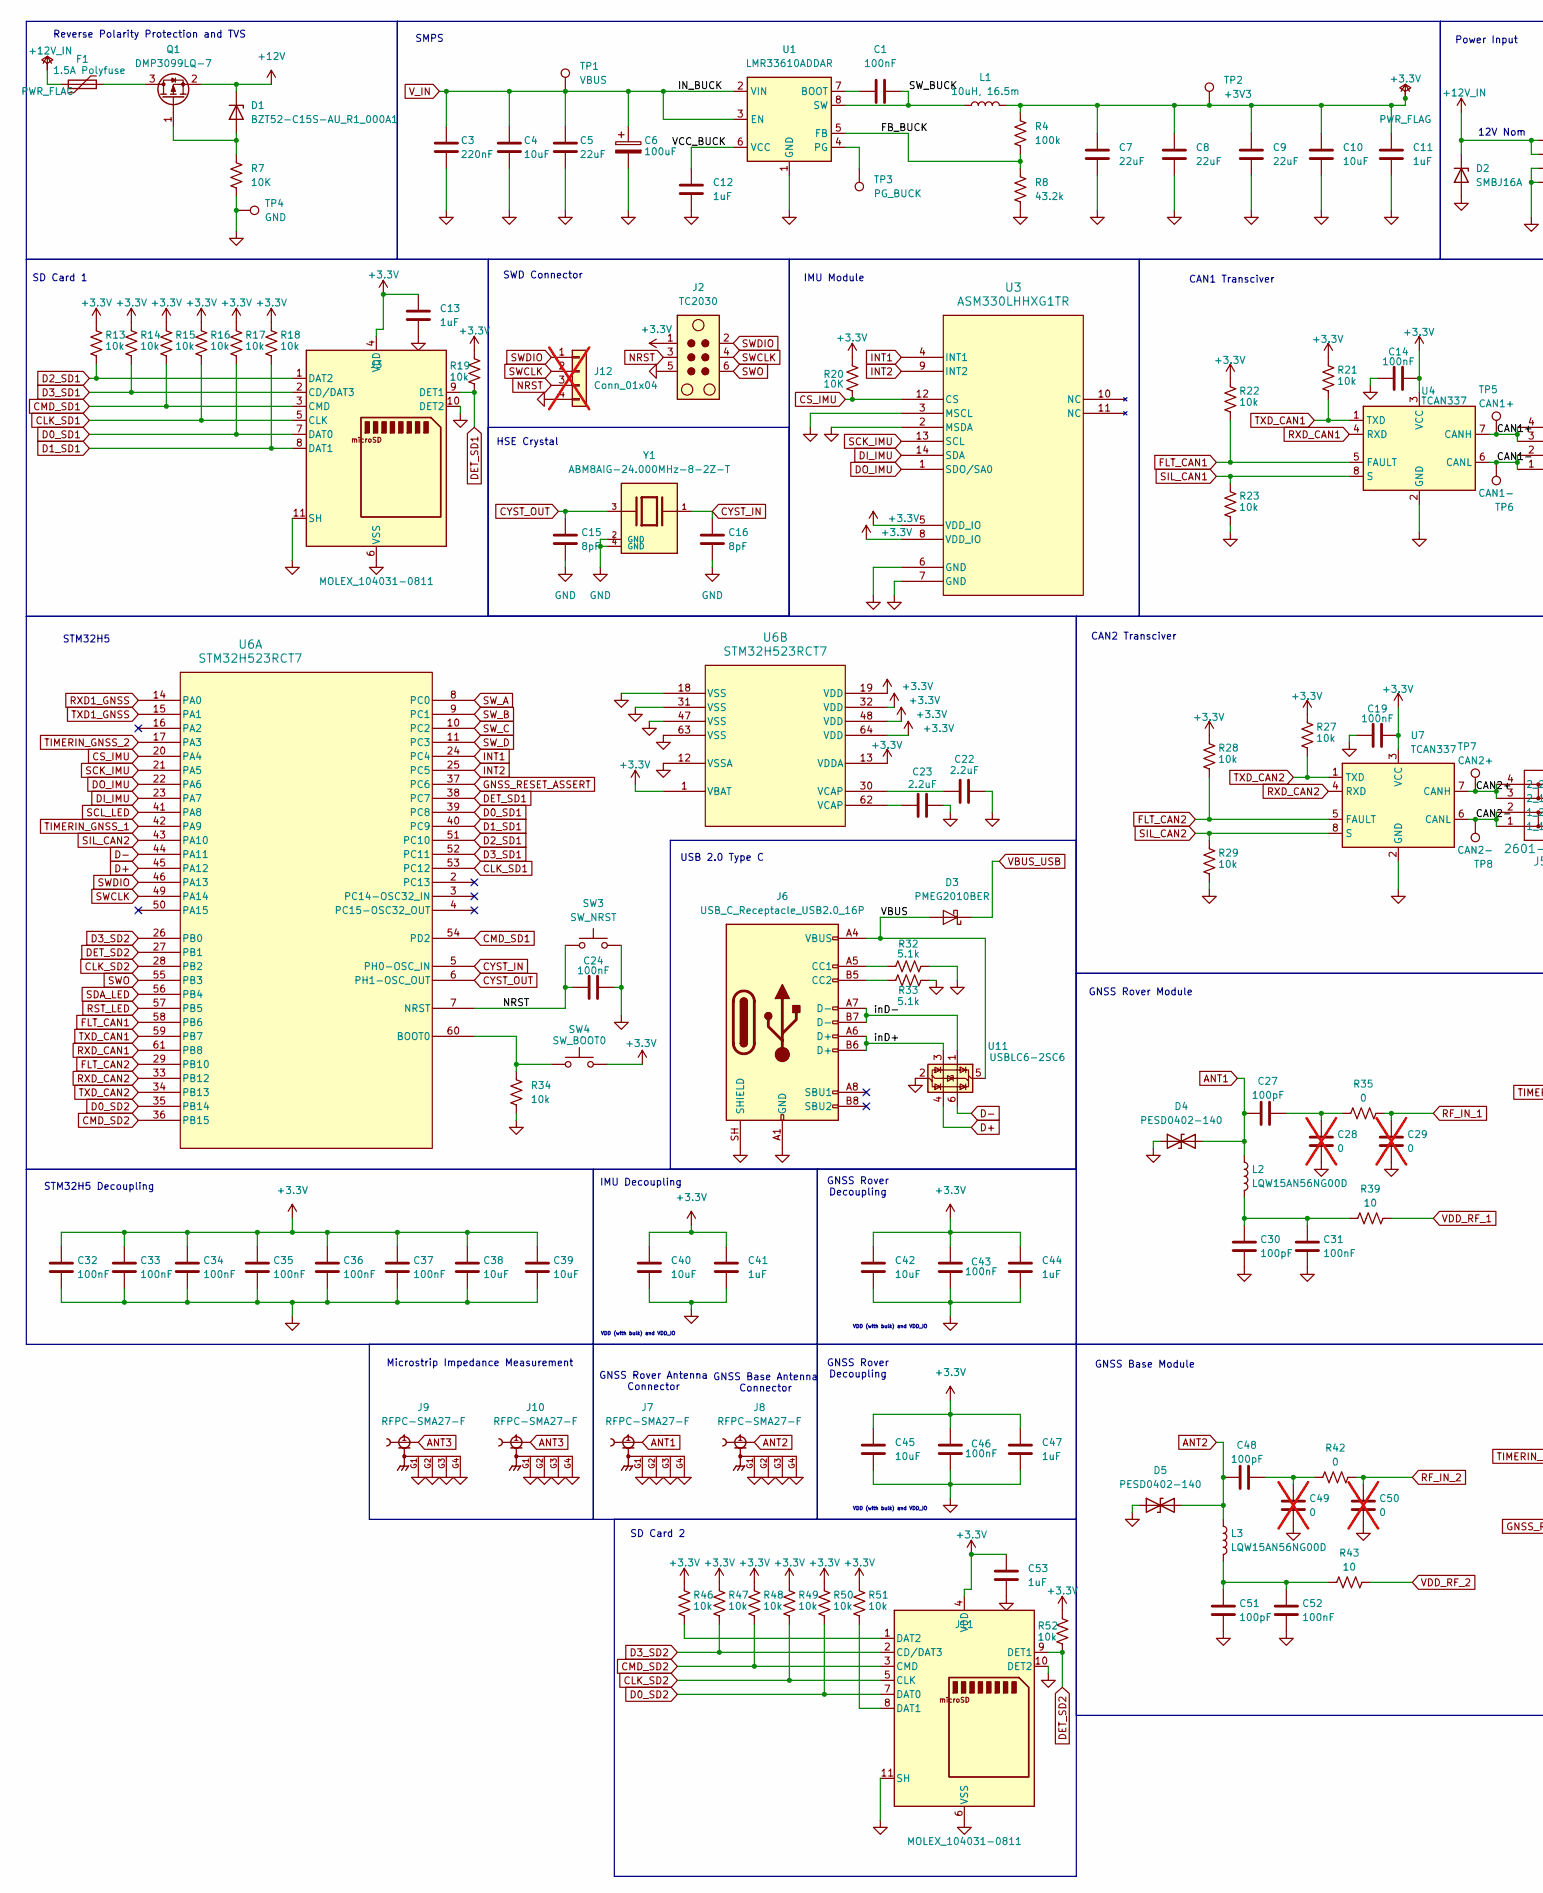
[picture p8: schematic telemetry.kicad_sch, part in row 1, column 1]

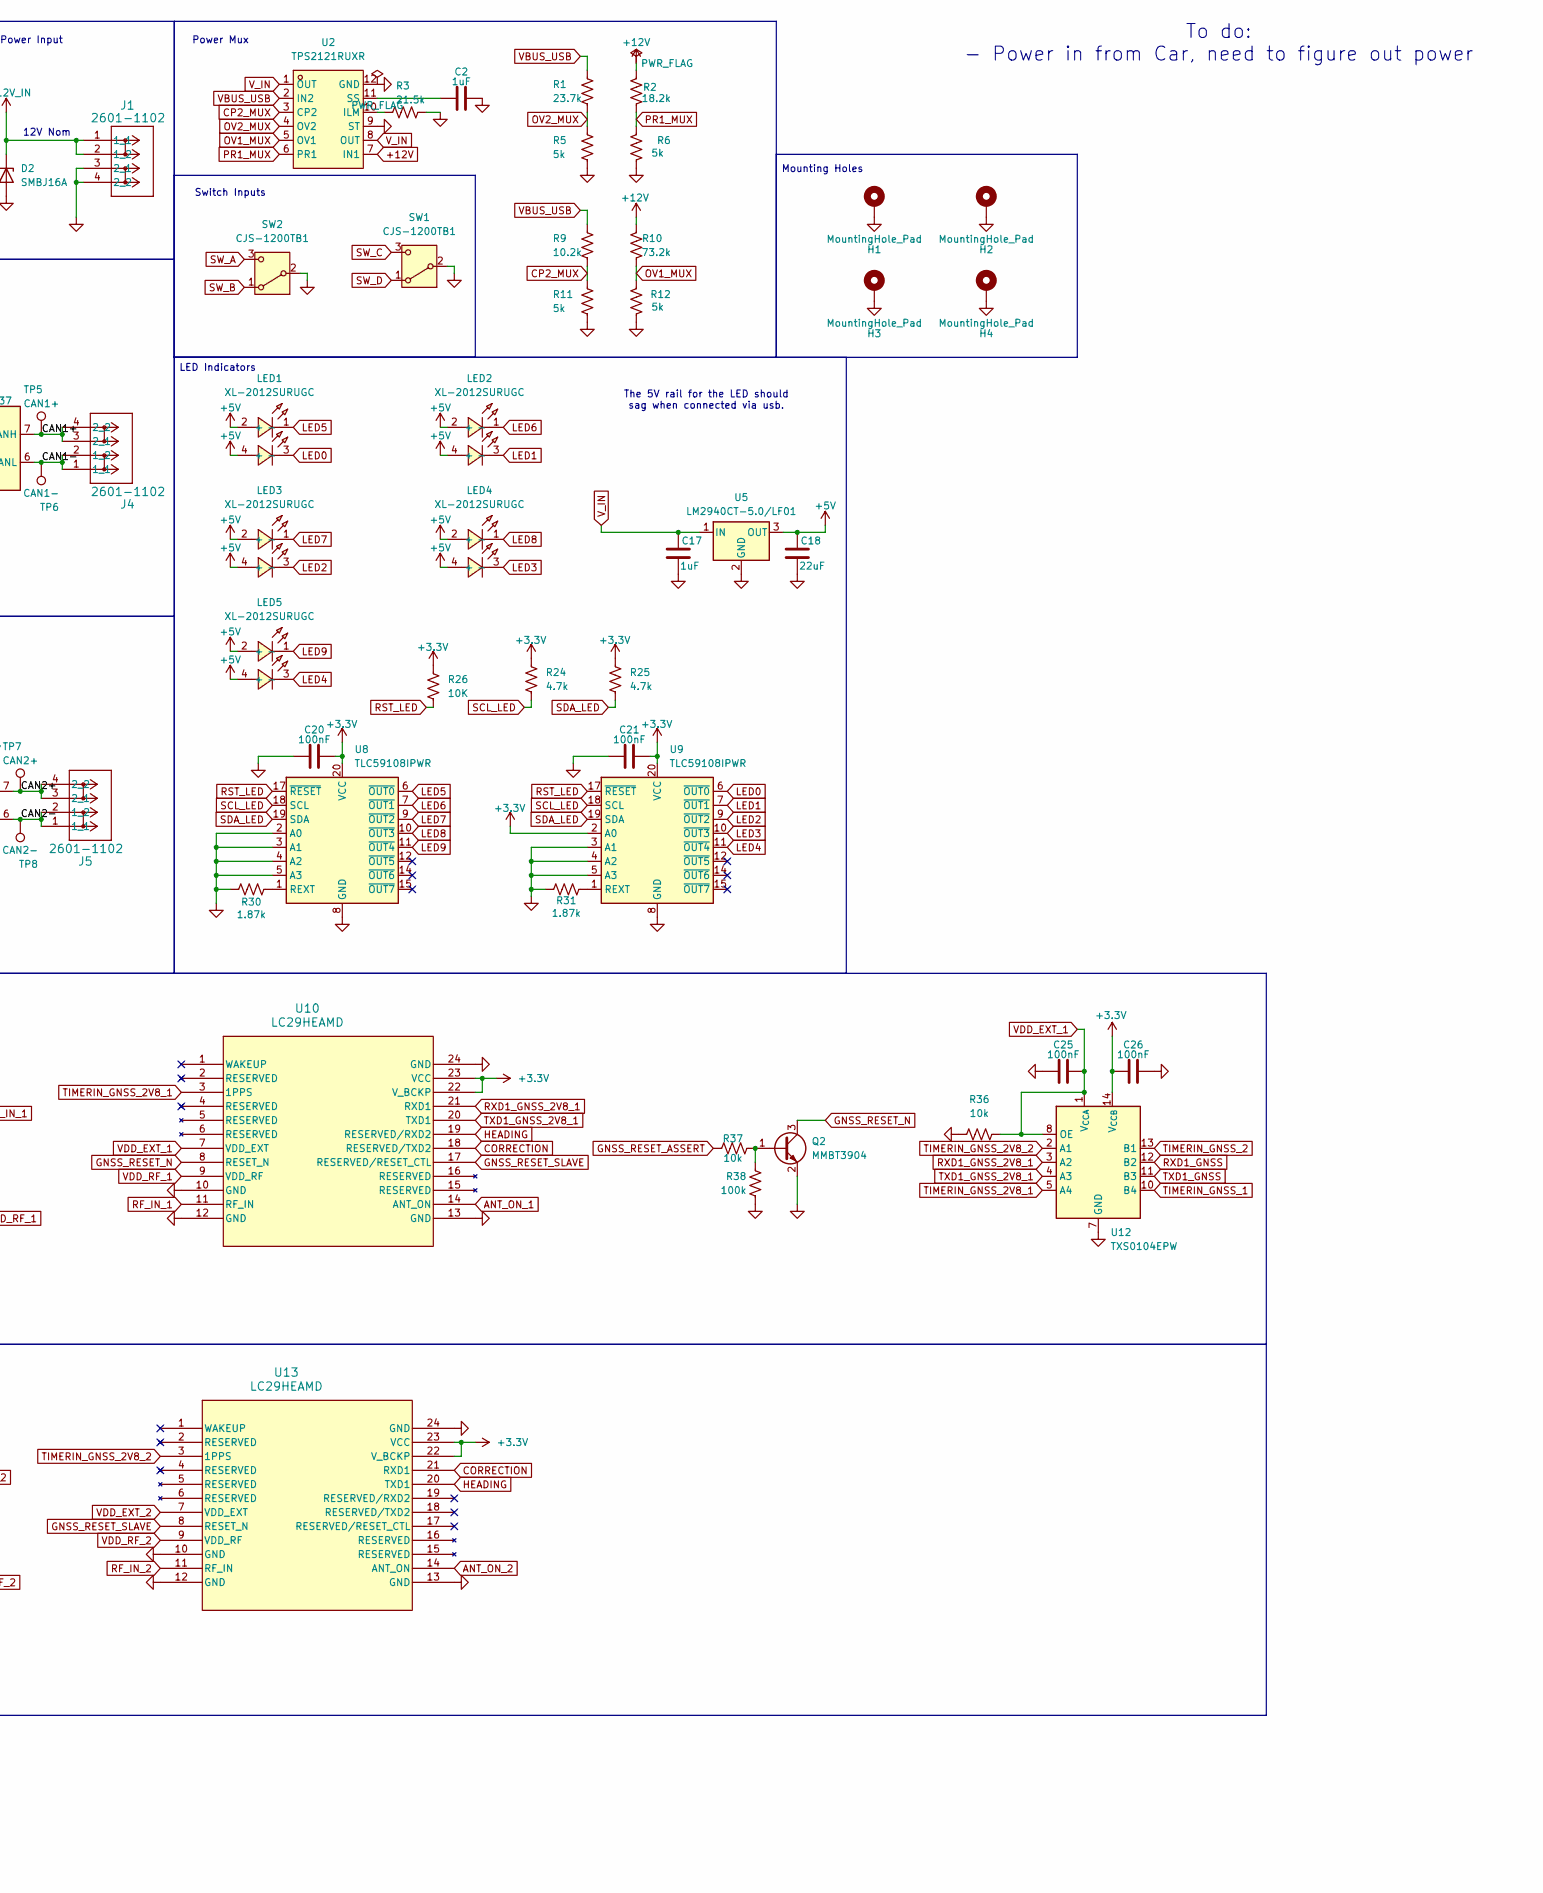
[picture p9: schematic telemetry.kicad_sch, part in row 1, column 2]

Parts:
C1, C14, C19, C20, C21, C24, C25, C26, C31, C32, C33, C34, C35, C36, C37, C43, C46, C52: 100nF; C_0402_1005Metric_Pad0.74x0.62mm_HandSolder
C2, C11, C12, C13, C17, C41, C44, C47, C53: 1uF; C_0402_1005Metric_Pad0.74x0.62mm_HandSolder
C3: 220nF; C_0402_1005Metric_Pad0.74x0.62mm_HandSolder
C4, C10, C38, C39, C40, C42, C45: 10uF; C_0402_1005Metric_Pad0.74x0.62mm_HandSolder
C5, C7, C8, C9, C18: 22uF; C_0402_1005Metric_Pad0.74x0.62mm_HandSolder
C6: 100uF; CP_Elec_6.3x7.7
C15, C16: 8pF; C_0402_1005Metric_Pad0.74x0.62mm_HandSolder
C22, C23: 2.2uF; C_0402_1005Metric_Pad0.74x0.62mm_HandSolder
C27, C30, C48, C51: 100pF; C_0402_1005Metric_Pad0.74x0.62mm_HandSolder
C28, C29, C49, C50: 0; C_0402_1005Metric_Pad0.74x0.62mm_HandSolder; not fitted
D1: BZT52-C15S-AU_R1_000A1; D_SOD-123
D2: SMBJ16A; MPN SMBJ16A; LCSC Part C151254
D3: PMEG2010BER; Nexperia_CFP3_SOD-123W
D4, D5: PESD0402-140; MPN PESD0402-140; LCSC Part C10662
F1: 1.5A Polyfuse; L_1812_4532Metric_Pad1.30x3.40mm_HandSolder
H1, H2, H3, H4: MountingHole_Pad; MountingHole_3.2mm_M3_Pad
J1, J4, J5: 2601-1102; WAGO-2601-1102
J2: TC2030; Tag-Connect_TC2030-IDC-FP_2x03_P1.27mm_Vertical
J3, J11: MOLEX_104031-0811
J6: USB_C_Receptacle_USB2.0_16P; USB-C-SMD_TYPE-C-16PIN-2MD-073
J7, J8, J9, J10: RFPC-SMA27-F; PARTREV 1.0
J12: Conn_01x04; PinHeader_1x04_P2.54mm_Vertical; not fitted
L1: 10uH, 16.5m; L_TaiTech_TMPC1265_13.5x12.5mm
L2, L3: LQW15AN56NG00D; MPN LQW15AN56NG00D; LCSC Part C167482
LED1, LED2, LED3, LED4, LED5: XL-2012SURUGC; MPN XL-2012SURUGC; LCSC Part C965845
Q1: DMP3099LQ-7; SOT-23
Q2: MMBT3904; SOT-23
R1: 23.7k; R_0402_1005Metric_Pad0.72x0.64mm_HandSolder
R2: 18.2k; R_0402_1005Metric_Pad0.72x0.64mm_HandSolder
R3: 21.5k; R_0402_1005Metric_Pad0.72x0.64mm_HandSolder
R4, R38: 100k; R_0402_1005Metric_Pad0.72x0.64mm_HandSolder
R5, R6, R11, R12: 5k; R_0402_1005Metric_Pad0.72x0.64mm_HandSolder
R7, R20, R26: 10K; R_0402_1005Metric_Pad0.72x0.64mm_HandSolder
R8: 43.2k; R_0402_1005Metric_Pad0.72x0.64mm_HandSolder
R9: 10.2k; R_0402_1005Metric_Pad0.72x0.64mm_HandSolder
R10: 73.2k; R_0402_1005Metric_Pad0.72x0.64mm_HandSolder
R13, R14, R15, R16, R17, R18, R19, R21, R22, R23, R27, R28, R29, R34, R36, R37, R46, R47, R48, R49, R50, R51, R52: 10k; R_0402_1005Metric_Pad0.72x0.64mm_HandSolder
R24, R25: 4.7k; R_0402_1005Metric_Pad0.72x0.64mm_HandSolder
R30, R31: 1.87k; R_0402_1005Metric_Pad0.72x0.64mm_HandSolder
R32, R33: 5.1k; R_0402_1005Metric_Pad0.72x0.64mm_HandSolder
R35, R42: 0; R_0402_1005Metric_Pad0.72x0.64mm_HandSolder
R39, R43: 10; R_0402_1005Metric_Pad0.72x0.64mm_HandSolder
SW1, SW2: CJS-1200TB1; MPN CJS-1200TB1; LCSC Part C2921631
SW3: SW_NRST; SMD-Switch
SW4: SW_BOOT0; SMD-Switch
TP1: VBUS; TestPoint_THTPad_D2.0mm_Drill1.0mm
TP2: +3V3; TestPoint_THTPad_D2.0mm_Drill1.0mm
TP3: PG_BUCK; TestPoint_THTPad_D2.0mm_Drill1.0mm
TP4: GND; TestPoint_THTPad_D2.0mm_Drill1.0mm
TP5: CAN1+; TestPoint_THTPad_D2.0mm_Drill1.0mm
TP6: CAN1-; TestPoint_THTPad_D2.0mm_Drill1.0mm
TP7: CAN2+; TestPoint_THTPad_D2.0mm_Drill1.0mm
TP8: CAN2-; TestPoint_THTPad_D2.0mm_Drill1.0mm
U1: LMR33610ADDAR; Texas_HSOP-8-1EP_3.9x4.9mm_P1.27mm_ThermalVias
U2: TPS2121RUXR; VQFN-HR-12_L2.5-W2.0-P0.50-BL; MPN TPS2121RUXR; LCSC Part C485916
U3: ASM330LHHXG1TR
U4, U7: TCAN337; SOIC-8_3.9x4.9mm_P1.27mm
U5: LM2940CT-5.0/LF01; TO-263-3_TabPin2; MPN LM2940CT-5.0/LF01
U6: STM32H523RCT7
U8, U9: TLC59108IPWR; MPN TLC59108IPWR
U10, U13: LC29HEAMD
U11: USBLC6-2SC6; SOT-23-6
U12: TXS0104EPW; TSSOP-14_4.4x5mm_P0.65mm
Y1: ABM8AIG-24.000MHz-8-2Z-T; ABM8AIG-24.000MHZ-8-2Z-T; PARTREV 43629

Connections:
+3.3V: C7.1, C8.1, C9.1, C10.2, C11.1, C13.1, C14.2, C19.2, C20.2, C21.2, C26.1, C32.1, C33.1, C34.1, C35.1, C36.1, C37.1, C38.1, C39.1, C40.2, C41.1, C42.2, C43.2, C44.1, C45.2, C46.2, C47.1, C53.1, J2.1, J3.4 (VDD), J11.4 (VDD), L1.2, R4.1, R13.1, R14.1, R15.1, R16.1, R17.1, R18.1, R19.1, R20.1, R21.1, R22.1, R24.1, R25.1, R26.1, R27.1, R28.1, R46.1, R47.1, R48.1, R49.1, R50.1, R51.1, R52.1, SW4.2, TP2.1 (1_1), U3.5 (VDD_IO), U3.8 (VDD_IO), U4.3 (VCC), U6.1 (VBAT), U6.13 (VDDA), U6.19 (VDD), U6.32 (VDD), U6.48 (VDD), U6.64 (VDD), U7.3 (VCC), U8.20 (VCC), U9.2 (A0), U9.20 (VCC), U10.22 (V_BCKP), U10.23 (VCC), U12.14 (V_{CCB}), U13.22 (V_BCKP), U13.23 (VCC)
+5V: C18.2, LED1.2 (+), LED1.4 (+), LED2.2 (+), LED2.4 (+), LED3.2 (+), LED3.4 (+), LED4.2 (+), LED4.4 (+), LED5.2 (+), LED5.4 (+), U5.3 (OUT)
+12V: D1.1 (K), Q1.2 (S), R2.1, R10.1, U2.7 (IN1)
+12V_IN: D2.1 (K), F1.1, J1.1 (1_1), J1.2 (1_2)
/CAN1+: J4.3 (2_1), J4.4 (2_2), TP5.1 (1_1), U4.7 (CANH)
/CAN1-: J4.1 (1_1), J4.2 (1_2), TP6.1 (1_1), U4.6 (CANL)
/CAN2+: J5.3 (2_1), J5.4 (2_2), TP7.1 (1_1), U7.7 (CANH)
/CAN2-: J5.1 (1_1), J5.2 (1_2), TP8.1 (1_1), U7.6 (CANL)
/FB_BUCK: R4.2, R8.1, U1.5 (FB)
/SW_BUCK: C1.2, L1.1, U1.8 (SW)
/VBUS: D3.2 (A), J6.A4 (VBUS), U11.5 (VBUS)
/VCC_BUCK: C12.1, U1.6 (VCC)
/inD+: J6.A6 (D+), J6.B6 (D+), U11.3 (I/O2)
/inD-: J6.A7 (D-), J6.B7 (D-), U11.1 (I/O1)
ANT1: C27.1, D4.2 (A2), J7.1, L2.1
ANT2: C48.1, D5.2 (A2), J8.1, L3.1
ANT3: J9.1, J10.1
ANT_ON_1: U10.14 (ANT_ON)
ANT_ON_2: U13.14 (ANT_ON)
CLK_SD1: J3.5 (CLK), R16.2, U6.53 (PC12)
CLK_SD2: J11.5 (CLK), R49.2, U6.28 (PB2)
CMD_SD1: J3.3 (CMD), R15.2, U6.54 (PD2)
CMD_SD2: J11.3 (CMD), R48.2, U6.36 (PB15)
CORRECTION: U10.18 (RESERVED/TXD2), U13.21 (RXD1)
CP2_MUX: R9.2, R11.1, U2.3 (CP2)
CS_IMU: R20.2, U3.12 (CS), U6.20 (PA4)
CYST_IN: C16.1, U6.5 (PH0-OSC_IN), Y1.1
CYST_OUT: C15.1, U6.6 (PH1-OSC_OUT), Y1.3
D0_SD1: J3.7 (DAT0), R17.2, U6.39 (PC8)
D0_SD2: J11.7 (DAT0), R50.2, U6.35 (PB14)
D1_SD1: J3.8 (DAT1), R18.2, U6.40 (PC9)
D2_SD1: J3.1 (DAT2), R13.2, U6.51 (PC10)
D3_SD1: J3.2 (CD/DAT3), R14.2, U6.52 (PC11)
D3_SD2: J11.2 (CD/DAT3), R47.2, U6.26 (PB0)
D+: U6.45 (PA12), U11.4 (I/O2)
D-: U6.44 (PA11), U11.6 (I/O1)
DET_SD1: J3.9 (DET1), R19.2, U6.38 (PC7)
DET_SD2: J11.9 (DET1), R52.2, U6.27 (PB1)
DI_IMU: U3.14 (SDA), U6.23 (PA7)
DO_IMU: U3.1 (SDO/SA0), U6.22 (PA6)
FLT_CAN1: R22.2, U4.5 (FAULT), U6.58 (PB6)
FLT_CAN2: R28.2, U6.29 (PB10), U7.5 (FAULT)
GND: C2.2, C3.2, C4.2, C5.2, C6.2, C7.2, C8.2, C9.2, C10.1, C11.2, C12.2, C13.2, C14.1, C15.2, C16.2, C17.1, C18.1, C19.1, C20.1, C21.1, C22.2, C23.2, C24.2, C25.1, C26.2, C28.2, C29.2, C30.2, C31.2, C32.2, C33.2, C34.2, C35.2, C36.2, C37.2, C38.2, C39.2, C40.1, C41.2, C42.1, C43.1, C44.2, C45.1, C46.1, C47.2, C49.2, C50.2, C51.2, C52.2, C53.2, D2.2 (A), D4.1 (A1), D5.1 (A1), H1.1 (1_1), H2.1 (1_1), H3.1 (1_1), H4.1 (1_1), J1.3 (2_1), J1.4 (2_2), J2.5, J3.6 (VSS), J3.10 (DET2), J3.11 (SH), J6.A1 (GND), J6.SH (SHIELD), J7.G1, J7.G2, J7.G3, J7.G4, J8.G1, J8.G2, J8.G3, J8.G4, J9.G1, J9.G2, J9.G3, J9.G4, J10.G1, J10.G2, J10.G3, J10.G4, J11.6 (VSS), J11.10 (DET2), J11.11 (SH), J12.4, Q2.2 (E), R3.2, R5.2, R6.2, R7.2, R8.2, R11.2, R12.2, R23.2, R29.2, R30.1, R31.1, R32.2, R33.2, R34.2, R36.1, R38.2, SW1.2 (B), SW2.2 (B), SW3.2, TP4.1 (1_1), U1.1 (GND), U1.9 (GND), U2.9 (ST), U2.12 (GND), U3.2 (MSDA), U3.3 (MSCL), U3.6 (GND), U3.7 (GND), U4.2 (GND), U5.2 (GND), U6.12 (VSSA), U6.18 (VSS), U6.31 (VSS), U6.47 (VSS), U6.63 (VSS), U7.2 (GND), U8.2 (A0), U8.3 (A1), U8.4 (A2), U8.5 (A3), U8.8 (GND), U8.13 (GND), U8.16 (GND), U9.3 (A1), U9.4 (A2), U9.5 (A3), U9.8 (GND), U9.13 (GND), U9.16 (GND), U10.10 (GND), U10.12 (GND), U10.13 (GND), U10.24 (GND), U11.2 (GND), U12.7 (GND), U13.10 (GND), U13.12 (GND), U13.13 (GND), U13.24 (GND), Y1.2 (GND), Y1.4 (GND)
GNSS_RESET_ASSERT: R37.1, U6.37 (PC6)
GNSS_RESET_N: Q2.3 (C), U10.8 (RESET_N)
GNSS_RESET_SLAVE: U10.17 (RESERVED/RESET_CTL), U13.8 (RESET_N)
HEADING: U10.19 (RESERVED/RXD2), U13.20 (TXD1)
INT1: U3.4 (INT1), U6.24 (PC4)
INT2: U3.9 (INT2), U6.25 (PC5)
LED0: LED1.3 (-), U9.6 (~OUT0)
LED1: LED2.3 (-), U9.7 (~OUT1)
LED2: LED3.3 (-), U9.9 (~OUT2)
LED3: LED4.3 (-), U9.10 (~OUT3)
LED4: LED5.3 (-), U9.11 (~OUT4)
LED5: LED1.1 (-), U8.6 (~OUT0)
LED6: LED2.1 (-), U8.7 (~OUT1)
LED7: LED3.1 (-), U8.9 (~OUT2)
LED8: LED4.1 (-), U8.10 (~OUT3)
LED9: LED5.1 (-), U8.11 (~OUT4)
NRST: C24.1, J2.3, J12.3, SW3.1, U6.7 (NRST)
unnamed: C22.1, U6.30 (VCAP)
unnamed: C23.1, U6.62 (VCAP)
unnamed: C27.2, C28.1, R35.1
unnamed: C30.1, C31.1, L2.2, R39.1
unnamed: C48.2, C49.1, R42.1
unnamed: C51.1, C52.1, L3.2, R43.1
unnamed: D1.2 (A), Q1.1 (G), R7.1
unnamed: J6.A5 (CC1), R32.1
unnamed: J6.B5 (CC2), R33.1
unnamed: J11.8 (DAT1), R51.2
unnamed: J11.1 (DAT2), R46.2
unnamed: F1.2, Q1.3 (D)
unnamed: Q2.1 (B), R37.2, R38.1
unnamed: C1.1, U1.7 (BOOT)
unnamed: TP3.1 (1_1), U1.4 (PG)
unnamed: R3.1, U2.10 (ILM)
unnamed: C2.1, U2.11 (SS)
unnamed: R34.1, SW4.1, U6.60 (BOOT0)
unnamed: R30.2, U8.1 (REXT)
unnamed: R31.2, U9.1 (REXT)
OV1_MUX: R10.2, R12.1, U2.5 (OV1)
OV2_MUX: R1.2, R5.1, U2.4 (OV2)
PR1_MUX: R2.2, R6.1, U2.6 (PR1)
RF_IN_1: C29.1, R35.2, U10.11 (RF_IN)
RF_IN_2: C50.1, R42.2, U13.11 (RF_IN)
RST_LED: R26.2, U6.57 (PB5), U8.17 (~RESET), U9.17 (~RESET)
RXD1_GNSS: U6.14 (PA0), U12.12 (B2)
RXD1_GNSS_2V8_1: U10.21 (RXD1), U12.3 (A2)
RXD_CAN1: U4.4 (RXD), U6.61 (PB8)
RXD_CAN2: U6.33 (PB12), U7.4 (RXD)
SCK_IMU: U3.13 (SCL), U6.21 (PA5)
SCL_LED: R24.2, U6.41 (PA8), U8.18 (SCL), U9.18 (SCL)
SDA_LED: R25.2, U6.56 (PB4), U8.19 (SDA), U9.19 (SDA)
SIL_CAN1: R23.1, U4.8 (S)
SIL_CAN2: R29.1, U6.43 (PA10), U7.8 (S)
SWCLK: J2.4, J12.2, U6.49 (PA14)
SWDIO: J2.2, J12.1, U6.46 (PA13)
SWO: J2.6, U6.55 (PB3)
SW_A: SW2.3 (C), U6.8 (PC0)
SW_B: SW2.1 (A), U6.9 (PC1)
SW_C: SW1.3 (C), U6.10 (PC2)
SW_D: SW1.1 (A), U6.11 (PC3)
TIMERIN_GNSS_1: U6.42 (PA9), U12.10 (B4)
TIMERIN_GNSS_2: U6.17 (PA3), U12.13 (B1)
TIMERIN_GNSS_2V8_1: U10.3 (1PPS), U12.5 (A4)
TIMERIN_GNSS_2V8_2: U12.2 (A1), U13.3 (1PPS)
TXD1_GNSS: U6.15 (PA1), U12.11 (B3)
TXD1_GNSS_2V8_1: U10.20 (TXD1), U12.4 (A3)
TXD_CAN1: R21.2, U4.1 (TXD), U6.59 (PB7)
TXD_CAN2: R27.2, U6.34 (PB13), U7.1 (TXD)
VBUS_USB: D3.1 (K), R1.1, R9.1, U2.2 (IN2)
VDD_EXT_1: C25.2, R36.2, U10.7 (VDD_EXT), U12.1 (V_{CCA}), U12.8 (OE)
VDD_EXT_2: U13.7 (VDD_EXT)
VDD_RF_1: R39.2, U10.9 (VDD_RF)
VDD_RF_2: R43.2, U13.9 (VDD_RF)
V_IN: C3.1, C4.1, C5.1, C6.1, C17.2, TP1.1 (1_1), U1.2 (VIN), U1.3 (EN), U2.1 (OUT), U2.8 (OUT), U5.1 (IN)

Notes on the sheet:
SMPS
GNSS Base Antenna Connector
SD Card 1
CAN1 Transciver
GNSS Base Module
STM32H5 Decoupling
GNSS Rover Module
STM32H5
The 5V rail for the LED should sag when connected via usb.
VDD (with bulk) and VDD_IO
SWD Connector
IMU Decoupling
Microstrip Impedance Measurement
GNSS Rover Antenna Connector
Reverse Polarity Protection and TVS
USB 2.0 Type C
GNSS Rover Decoupling
SD Card 2
Power Input
CAN2 Transciver
Mounting Holes
HSE Crystal
IMU Module
12V Nom
To do: - Power in from Car, need to figure out power
Switch Inputs
Power Mux
LED Indicators

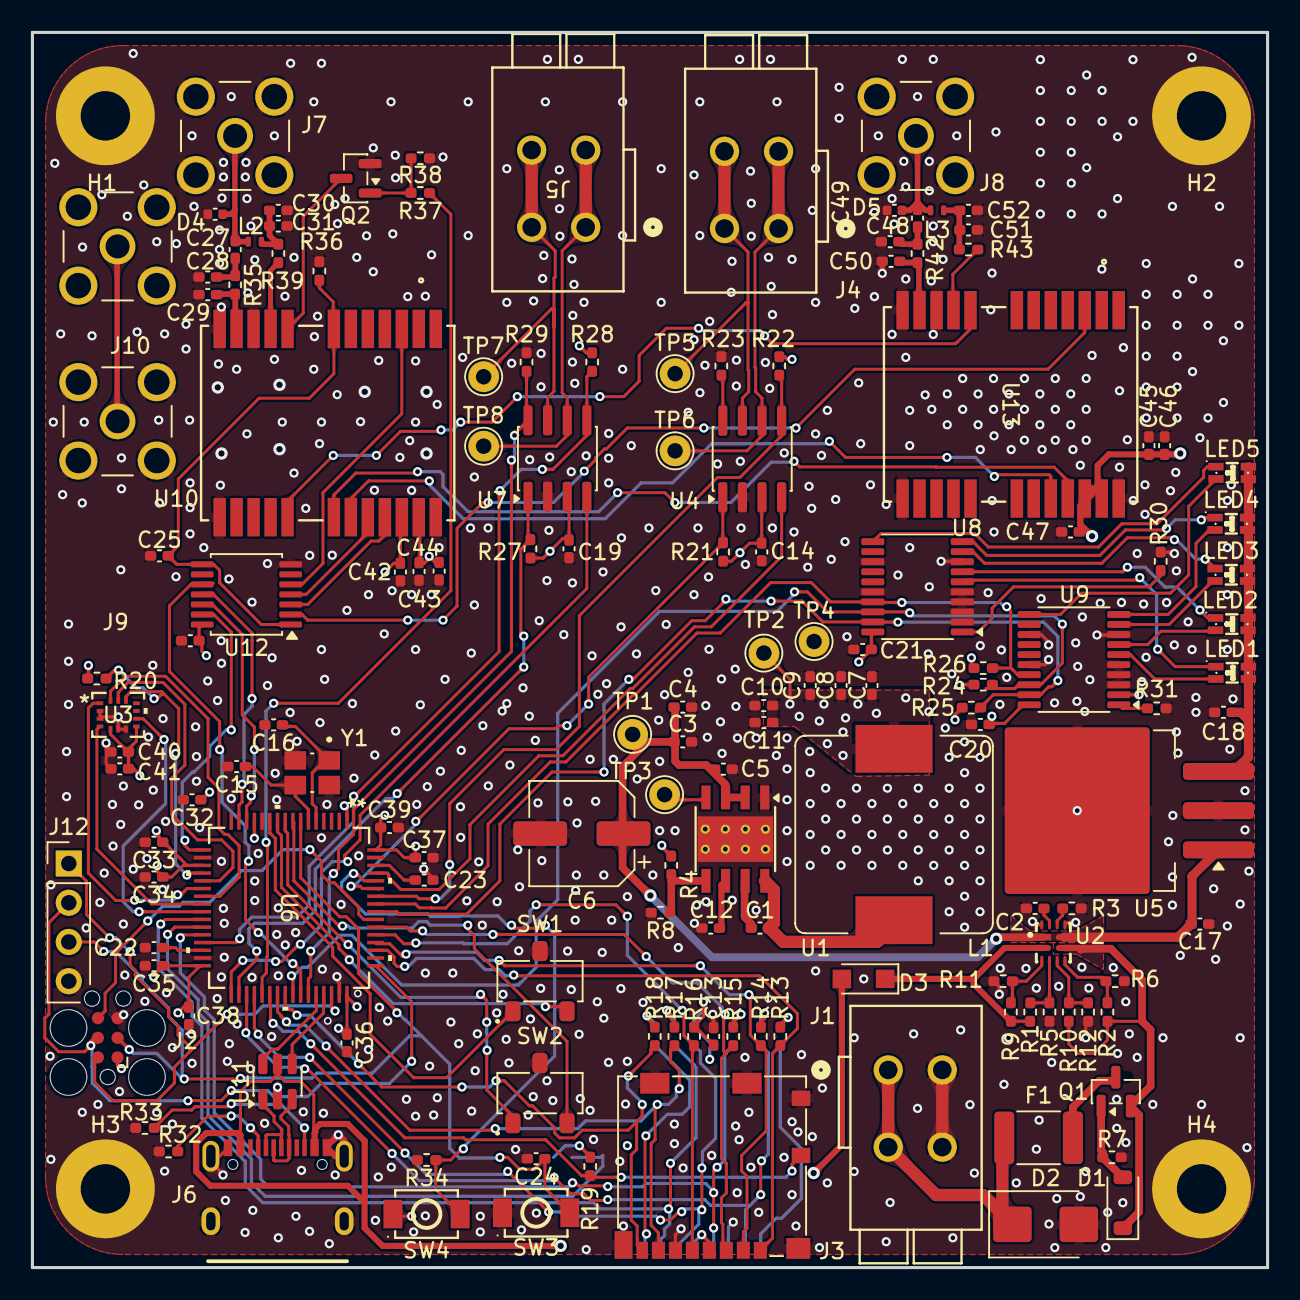
[picture p10: board telemetry.kicad_pcb from above]

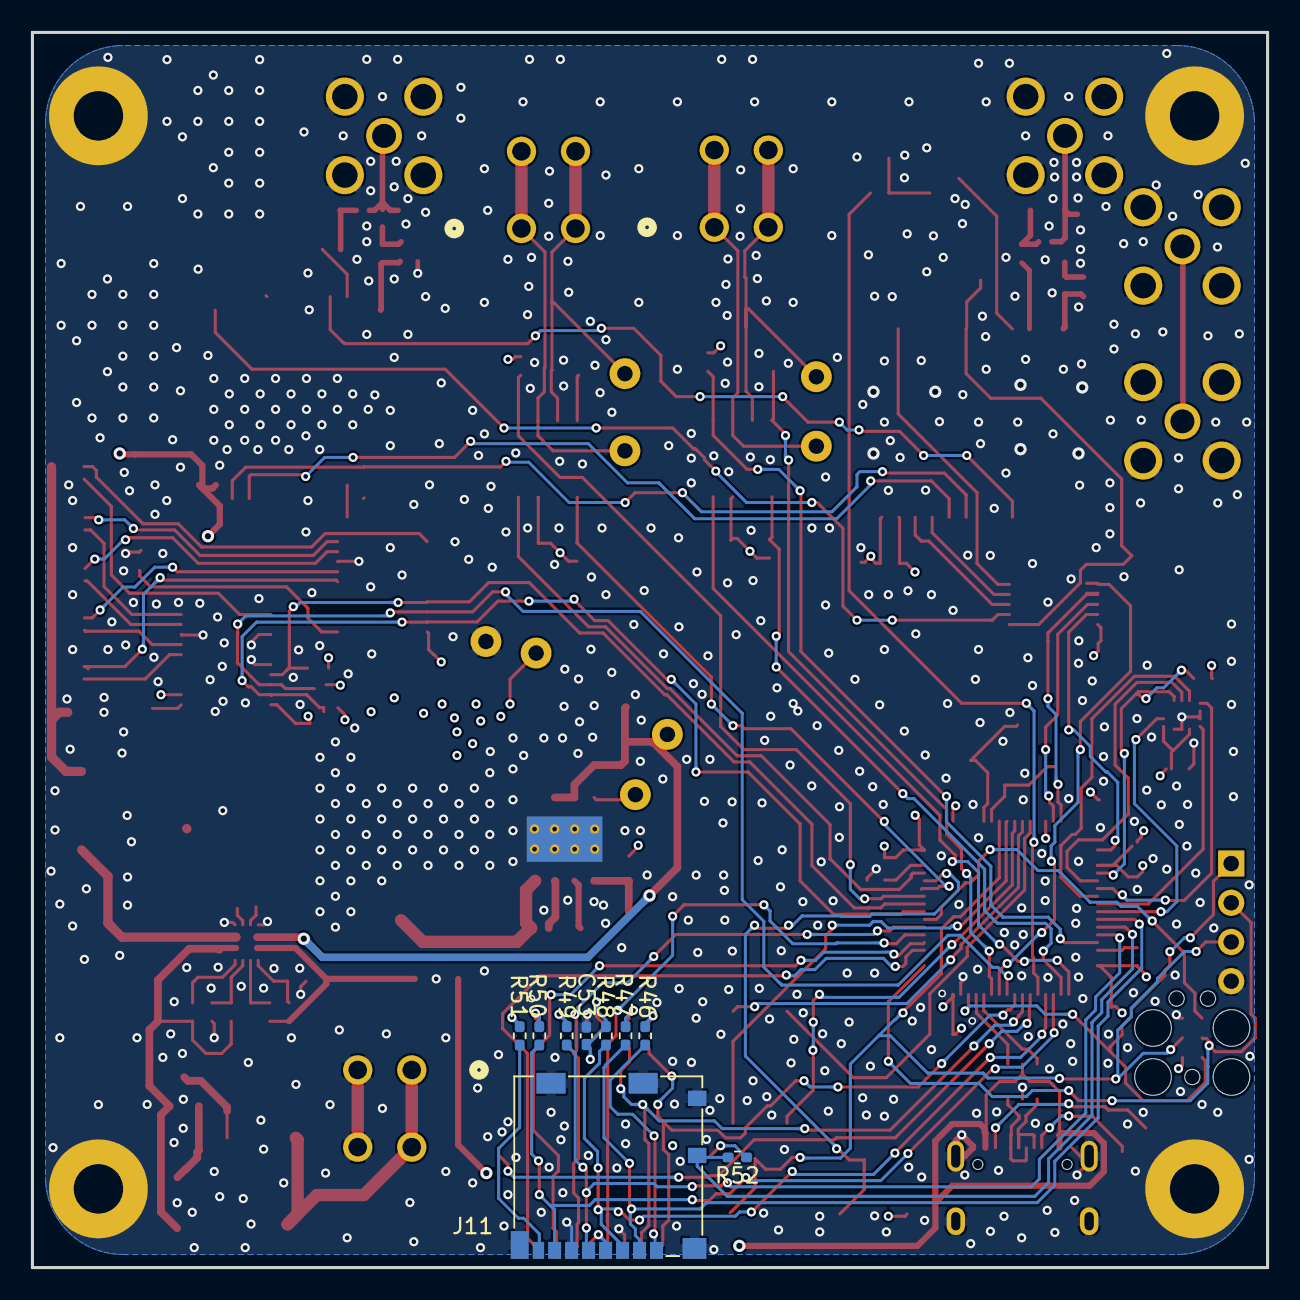
[picture p11: board telemetry.kicad_pcb from below]

Board: 4 copper layers, 80.0 x 80.0 mm, 159 parts (9 on the bottom side), 113 nets.
