chithigun23/ANUFS-Telemetry/(commit log)

2026-08-06 Kicad setup
    [MAX-M10S-00B--3DModel-STEP-269445.STEP, telemetry.kicad_pcb, telemetry.kicad_sch]
2026-08-07 Added sym, footprint and 3d for each of the main components
    [ASM330LHHXG1TR.step, MAX-M10S-00B.step, STM32H523CCU6.step, TCAN1044VDRQ1.stp]
2026-08-09 Changed MCU to LQFP64 footprint, added TVS and reverse polarity protection, added buck converter chip.
    [SMD-Switch.step, STM32H523CCU6.step, STM32H523RCT7.step, telemetry.kicad_sch]
2026-08-10 Developed schematic with all components, need to check Ublox integration and STM32 USB debugging and impliment SWD.
    [telemetry.kicad_sch]
2026-08-13 Added power mux between USB and 12V car power
    [telemetry.kicad_sch]
2026-08-14 Removed power mux status being used to switch off buck, the buck has a tiny quiessant current which is acceptable
2026-08-14 Added flash and improved from suggestions. Power status flags go into MCU. Need to work on MCU Pin Plan and update documentation
2026-08-16 Schematic wiring, CAN terminal block added and SMA connector added
2026-08-16 Updated foot print and small fixes. Might change the power plan.
2026-08-16 Flash removed, no real need. Switched to full size SD card and fixed power issues. Need to add LEDs for debugging and status.
2026-08-18 Begun placement, need to make a footprint for the SD card module. All other footprints are loaded. Routing considerations are not input, such as the impidence controlled antenna trace.
2026-08-20 Routing Progressed, used Kicad MCP to make schematic for SD card
2026-08-30 Added indicating LEDs
2026-08-31 PCB draft complete
2026-09-11 Added 12V/USB_5V power mux and level shifting for GNSS module
2026-09-11 Solved resistors for TPS2121 power mux operation
2026-09-14 All 3d files added, layout mostly done. some progress routing. schematic is finalised. Switched to microsd card.
2026-09-14 Finished all design, no DRC issues. Added BOM, cleaned folder
2026-09-18 Changed to LC29HEAMD for better RTK 10cm -> 1cm. Changed to active antenna, some passives required.
2026-09-18 Switched to TC2030 with legs, small fixes. 3D models and LDO changed.
2026-09-21 Changed decoupling from 1uF to 100nF, added capcitance to Power Mux output
2026-09-21 Impediance measurment added, full pi filter for each antenna implimented
2026-09-21 Add RF analysis plan and openEMS simulation scripts; use JLCPCB stackup values
    - RF Analysis/: plan for the GNSS antenna-path reflection study, short-section
    test note, software setup guide, and laptop handover
    - RF Analysis/sim/: openEMS/RFsim scripts (bare ANT3 line, ANT1 4-port chain)
    - telemetry.kicad_pcb: stackup dielectric constants set to JLCPCB JLC04161H-7628
    (prepreg 4.4, core 4.6), plus current routing edits
2026-09-21 RF analysis: record first simulation results, add 9.5 mm test mode, update laptop handover
    - Short-Section-Test.md: 5 mm run gave line Z0 of about 46-47 ohm; S-parameters invalid
    - step1_ant3.py: add "long" (9.5 mm) section mode alongside "short"
    - Laptop-Handover.md: laptop first runs the 9.5 mm diagnostic, then the 4-port ANT1 job
2026-09-21 RF results from laptop: Stage A step1_long_coarse (INVALID, solver diverged)
    ANT3 9.5 mm bare line, coarse mesh, openEMS 0.37.0-rc2, 134x110x39 cells.
    Energy grows exponentially after the excitation ends and reaches inf at
    230000 steps (both ports). Line Z0 printed as 50.0-9.8j (port 1, eps_eff
    106) and 3.9+4.7j (port 2, eps_eff 1199). Solver warns port 1 gives out
    more power than it takes in (max sum|S|^2 = 79.25). S-parameters are not
    usable. solver.log force-added (root .gitignore excludes *.log).
2026-09-21 RF analysis: record 9.5 mm results (solver diverges on both machines) and diagnostics plan
2026-09-21 RF results from desktop: 5 mm and 9.5 mm bare-line runs (both invalid; 9.5 mm solver diverged)
2026-09-21 RF results from desktop: 9.5 mm run with perfect-conductor copper (still diverges)
    Copper sheet model is not the cause of the instability. Also adds ENDCRIT run option.
2026-09-21 RF results from laptop: Stage A timestep-factor 0.5 (INVALID, still diverges)
    ANT3 9.5 mm line, coarse mesh, port 1 only, TSF=0.5 (dt 8.33e-15 s), step
    cap 600000. Energy still grows exponentially and reaches inf at 445000
    steps (3.7 ns simulated, 1h11m wall clock). Port 1 line Z0 = 52.6-19.9j ohm,
    eps_eff = 114. Solver warns port 1 gives out more power than it takes in
    (max sum|S|^2 = 62.4). S21 = +17.5..17.9 dB, not physical.
    Observation: the energy growth rate per ns of SIMULATED time is the same
    in all three diverging runs, about 36.7 /ns (e-fold of energy every 27 ps):
    TSF 1.0 (laptop): 6.9e5 at 2.42 ns -> 4.3e27 at 3.79 ns
    TSF 0.5 (laptop): 2.4e5 at 2.29 ns -> 2.2e25 at 3.54 ns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
2026-09-21 RF analysis: 5 mm run to full step cap is stable but S-parameters still invalid; add PORTTYPE option and offline repostprocess tool
2026-09-21 RF results from laptop: 9.5 mm with lumped ports, port 1 only (INVALID, still diverges)
    PORTTYPE=lumped, EXCITE=1, coarse mesh. The lumped-port model has a smaller
    domain (64x83x39 = 207168 cells, dt 4.60e-14 s, 49816-step excitation).
    Energy decays correctly after the excitation (1.4e-12 at 1.42 ns down to
    5.7e-15 at 2.33 ns), then a growing mode starts at about 2.8 ns and reaches
    inf at 178285 steps (8.2 ns), 15 min wall clock at 40 MCells/s.
    Warning present: port 1 gives out more power than it takes in
    (max sum|S|^2 = 43950). S11 +1.9 dB, S21 +46 dB, not physical.
    Comparison: growth rate of the energy is about 17.4 e-folds per ns here, versus
    about 36.7 per ns in the three microstrip-por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
2026-09-21 RF results from laptop: 5 mm lumped model with lossless dielectrics (INVALID, still diverges)
    Desktop's step1_short_coarse_lumped model.json run with --tand0 (loss tangent
    0 on all three dielectric layers, kappa = 0 in the FDTD), 55x72x39 = 154440
    cells, dt 4.38e-14 s. Energy still grows exponentially and reaches inf at
    126483 steps (5.5 ns), same step as the desktop's tand 0.02 run.
    Energy differs from the tand 0.02 run by only about 1-2 percent at 100 of 132
    logged steps (4.54e-14 vs 4.49e-14 at step 40893; 1.24e26 vs 1.21e26 at step
    120777) and the growth rate is the same, 25.8 e-folds per ns for both. Dielectric
    loss is therefore not the cause of the instability.
    Warning present: port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
2026-09-21 RF results from laptop: 5 mm lumped model, F.Cu signal trace only (INVALID, still diverges)
    Desktop's step1_short_coarse_lumped model.json run with --signal-only: F.Cu
    reduced to 1 polygon (the trace with both port pads, x 18.1-18.42, y -34.66 to
    -29.34; the original has 12), inner and bottom planes unchanged. 54x70x39 =
    147420 cells, dt 4.24e-14 s.
    Energy still grows exponentially and reaches inf at 132705 steps (5.6 ns),
    6m32s wall clock at 50 MCells/s. Growth rate about 26.0 e-folds per ns, the
    same as the unmodified 5 mm lumped model (25.8) and the lossless one (25.8).
    So removing the ground pour beside the trace does not change the instability.
    Warning present: port 1 gives out more p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
2026-09-21 RF results from laptop: plugin validation model at 1-6 GHz, run long (STABLE, valid)
    Control for the frequency-range question. The plugin's own microstrip
    validation model (47x41x35 = 67445 cells, dt 8.66e-13 s, 1324-step excitation)
    with its own 1-6 GHz range, early stop disabled (--endcrit 1e-12), step cap
    150000 (113 x the excitation), both ports excited.
    Energy decays smoothly and monotonically on both excitations, from -45 dB to
    -107.6 dB at 150000 steps (123 ns simulated), with no growth. No warning that a
    port gives out more power than it takes in. Z0 = 47.7+1.7j ohm, eps_eff = 3.79.
    S11 -22.6..-11.0 dB, S21 -0.2 dB, S12 -0.2 dB, S22 -22.6..-11.0 dB.
    Speed 36.8-37.8 MCells/s. Both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
2026-09-21 RF analysis: the plugin's own 2-layer validation board diverges late when run at 0.5-3 GHz
2026-09-21 RF results from laptop: validation model frequency tests (0.5-6 GHz stable, 1-3 GHz unstable)
    Plugin validation model, early stop disabled (--endcrit 1e-12), cap 150000 steps,
    both ports excited. Only the sweep limits change.
    0.5-6 GHz (validation_msl_0p5_6): STABLE. Same mesh (2.355 mm, 47x41x35 cells) and
    dt 8.66e-13 s as the 1-6 GHz control; excitation 1203 steps. Energy decays
    smoothly to -97.2 dB at 150000 steps (~130 ns) on both excitations. Z0 = 47.8+1.6j
    ohm, eps_eff 3.79. S11 -23.0..-11.0 dB, S21 -0.2..-0.1 dB. No power warning.
    A low START frequency does not trigger the instability.
    1-3 GHz (validation_msl_1_3): UNSTABLE. Mesh 4.711 mm (34x37x27 cells), dt 4.83e-13 s,
    excitation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
2026-09-21 RF analysis: 1-1.8 GHz sweeps diverge on both the validation model and the 5 mm lumped model
2026-09-21 RF analysis: 5 mm lumped model still diverges at 0.5-6 GHz; add --mesh option
2026-09-21 RF analysis: first valid simulation - 5 mm bare line, fine mesh, lumped ports (S11 <= -21 dB, S21 ~ 0 dB)
    Coarse mesh causes the late-time instability on this model; validation board is stable at the medium mesh.
2026-09-21 RF analysis: 9.5 mm fine-mesh run stable but no transmission (ports probably over connector clearance holes); ANT1 script uses lumped ports
2026-09-21 RF analysis: first ANT1 4-port run (fine mesh, stable) shows no transmission; cause found: empty pi-filter pads modelled as 0.25 nH shunts
2026-09-22 RF results from laptop: 5 mm lumped model at the MEDIUM mesh (INVALID, still diverges)
    run_variant.py --mesh medium on the desktop's step1_short_coarse_lumped model.json.
    Mesh 2.330 mm, 55x80x39 = 171600 cells, dt 4.99e-14 s, 45964-step excitation,
    cap 300000. Energy decays to 1.8e-14 at 1.3 ns, then grows: above 1e-3 at 2.46 ns,
    inf at 106045 steps (5.3 ns), 9m13s wall clock at about 33 MCells/s.
    Growth rate 26.2 e-folds per ns, the same as the coarse lumped runs (25.8-26.0), so
    the medium preset does not change the instability on this model.
    Warning that port 1 gives out more power than it takes in (sum|S|^2 = 121).
    S11 -5.9..-4.3 dB, S21 +12.7..+20.8 dB in the bands; not physical.
    Only th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
2026-09-22 RF analysis: add Desktop-Handover.md, port_coverage.py, un-ignore solver logs
    Desktop-Handover.md: what to trust, the problems found in the current models,
    the ordered job list, and rules for storing results in git.
    port_coverage.py: checks that every port in a model.json has copper under it on
    its reference layer. The 9.5 mm ANT3 section (step1_ant3.py long) fails it: both
    ports sit on the SMA clearance cutouts with no plane copper below, which explains
    the opaque fine-mesh result and the absurd coarse microstrip Z0 (3.9+4.7j ohm,
    eps_eff 1199). The 5 mm section and all four ANT1 ports pass.
    results/.gitignore: un-ignore solver*.log (the root .gitignore has *.log), so solver
    logs are comm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
2026-09-22 RF results from laptop: 5 mm fine-mesh model run long, STABLE and valid; update desktop handover
    Same model as desktop/step1_short_fine_lumped (325941 cells, 1.165 mm, dt 6.59e-14 s), early stop
    disabled, cap 120000 steps (7.9 ns), 14 min at 46 MCells/s. Energy decays monotonically
    from the end of the excitation to -85.1 dB, no growth in any progress line after step 60000
    (the coarse and medium runs blew up between 1.3 and 2.5 ns onward). No power warning.
    S11 -36.2..-21.2 dB, S21 -0.08..-0.04 dB over 0.5-3 GHz, max sum|S|^2 = 0.9921. Differs from
    the early-stopped desktop run by at most 0.0003 in |S11| and 0.0014 in |S21|, so the early-stopped
    result was not contaminated. Stability is confi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
2026-09-22 RF analysis: rerun ANT1 4-port with the pi-filter-pad fix; near-total reflection at ports 1/2 (likely lumped-port artifact), 7 mm section ready for a microstrip line-impedance test
2026-09-22 RF analysis: move validated runs to results/_keep/, tighten committed-file policy
    Per Next-Steps-Sonnet.md section 1. Moved into results/_keep/<machine>/, no content changed:
    desktop/step1_short_fine_lumped, laptop/step1_short_fine_lumped_long, laptop/validation_msl_1_6,
    laptop/validation_msl_0p5_6, desktop/validation_msl_medium_0p5_3, desktop/validation_stripline_long
    (the toolchain-validation and 5 mm bare-line results).
    Added laptop/step1_long_fixed_fine_lumped (7 mm ANT3 section, ports moved off the SMA clearance
    cutouts onto plane copper, fine mesh, lumped ports, both excited): stable (ends on the energy
    criterion, not divergence or the step cap), no power warning, passive (max sum|S|^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
2026-09-22 remove invalid RF runs
    Per Next-Steps-Sonnet.md section 1: every coarse- and medium-mesh board run diverged or broke
    passivity; the 9.5 mm "long" runs had ports on the SMA clearance cutouts; the first ANT1 run
    modelled the empty pads as shorts. None of these are usable board data.
    Removed (all confirmed present in git history before this commit, so recoverable):
    desktop: step1_long_coarse, step1_long_coarse_pec, step1_long_fine_lumped, step1_short_coarse_lumped,
    step1_short_coarse_lumped_f0p5_6, step1_short_coarse_lumped_f1_1p8, step1_short_coarse_lumped_mur,
    step1_short_coarse_lumped_signalonly, step1_short_coarse_lumped_slab,
    step1_short_coarse_lumped_solidplanes, step1_short_coarse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
2026-09-22 RF analysis: microstrip ports on the 7 mm section are also invalid at the fine mesh, differently from the ANT1 lumped-port result; pausing blind sweeps pending user direction
2026-09-22 Task A: valid line impedance without FDTD (closes H5) - Z0 is 54-56 ohm, above target
    sim/task_a_line_impedance.py reads telemetry.kicad_pcb as plain text (no pcbnew, read only), measures
    the real coplanar gap for ANT1/ANT2/ANT3 from the Ground Pour zone's cached fill polygons (clipped
    locally per line for speed - the board-wide island has ~25000 vertices), and computes Z0 two
    independent ways: closed-form grounded-CPW (Ghione-Naldi/Wadell) and a 2D finite-difference Laplace
    solve (energy method), plus a plain-microstrip figure for comparison.
    Measured gaps: ANT1 0.315 mm, ANT2 0.355 mm, ANT3 0.205 mm (median of 35-83 samples per line).
    The two Z0 methods disagree by 75-120%. The closed-fo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
2026-09-22 Task B: mesh_check.py + lumped-port trace-width fix (mesh-only, not yet solved)
    mesh_check.py reuses the plugin's own _port_geometry/_mesh/SmoothMeshLines to report the exact
    FDTD mesh a model would use: min/max cell, worst neighbour-cell ratio, cells across the trace,
    cells through each dielectric layer.
    Tested item 2's hypothesis (neighbour ratio > ~2 causes the divergence) on the valid fine 5mm
    model vs the same model regenerated at coarse: worst ratios are 4.4/9.6/4.6x (fine, stable) vs
    15.0/20.3/36.0x (coarse, diverges) in x/y/z. Not a clean ">2" cutoff (fine already reaches 9.6x),
    but coarse is consistently worse in every axis, most in z, where both hit their worst jump at the
    same z=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
2026-09-22 Task C: validation test for detecting a Z0 error - works on the 5mm baseline, not the 7mm one
    Step 1: 7mm fixed-port section (Task B mesh fix, both ports, lumped): the trace-width fix does NOT
    fix the near-total-reflection problem (S11 -0.9..-0.0 dB, unchanged from before the fix). Not a
    mesh-resolution artifact; cause still open.
    Step 2: run_variant.py --trace-width (rescales the actual F.Cu trace polygon, not just a label,
    about the line's own x; leaves the pour where it is) and --excite-all (overrides a saved
    model.json's excite:[1]) and --runner-file (choose the runner script). On the 7mm baseline
    (already saturated near total reflection) widening to 0.60mm barely moves S11 (-0.9..-0.0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
2026-09-22 Task D: circuit model of the ANT1 and ANT2 chains - both pass comfortably (ideal components)
    sim/chain_model.py, scikit-rf. Vendor Touchstone files not obtained: Murata SimSurfing's search
    UI did not return results despite a genuine debugging attempt (fixed a duplicate-text input bug
    via its own jQuery API, triggered the real search button, checked network/DOM for a client-side
    dataset - results grid stayed empty). User chose ideal component models instead: L2/L3 keep
    embed_l2.py's existing 56nH+2.8GHz-SRF+1.5ohm model, 100pF caps ideal C0G, D4/D5 the plan's
    assumed 0.05pF (no public S-parameter file exists for the TVS anyway).
    Topology and every segment length are derived from telemetry.ki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
2026-09-22 Investigate near-total-reflection cause before Task E - found a 5-6mm length threshold, not location
    Before spending compute on Task E's ANT1 4-port run, investigated why lumped ports give near-total
    reflection beyond ~5mm (Task C step 1). Ruled out: a stray via shorting the trace (checked model.json
    vias against the trace path, none present); coincident port1/port2 peak timing being anomalous
    (expected for an electrically short line, same in the working 5mm case); a pure S-parameter
    post-processing artifact (the raw time-domain peak voltage at port2 is genuinely only ~34% of port1's
    own peak in the 7mm case vs ~102% in the 5mm case - the defect is in the fields/ports, not just the
    S-paramet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
2026-09-22 Field-dump visualization: near-total reflection matches a parasitic cavity resonance in the ground pour
    sim/experiments/field_heatmap.py plots the frequency-domain E-field magnitude on the substrate
    mid-plane (Ef.h5, port 1 excitation) for the broken 6mm probe6mm case against the working 5mm
    baseline, log scale, same colour range, port positions marked.
    5mm (good): field tightly confined to a narrow guided stripe along the trace between the ports -
    a properly guided transmission-line mode.
    6mm (broken): field floods a large fraction of the surrounding ground-pour copper at near-uniform
    high intensity, not confined to the trace.
    Consistent with the lumped ports exciting a parasitic cavity/c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
2026-09-22 Task E: msl ports on real ANT1 chain also fail (exponential divergence)
    Tried msl/cpw ports on ports 1/2 of the actual ANT1 4-port model as a
    mode-selective alternative to lumped ports, per the cavity-resonance
    finding in Task E prep. Added D4CAP_PF, RUNNER, ENDCRIT/MAXSTEPS env
    var support to step5_ant1_multiport.py to enable this and future runs.
    Result: fails too, a third distinct failure mode from lumped ports'
    near-total reflection and the earlier bare-line msl power-conservation
    violation. Energy decayed to -17.35dB then grew back smoothly through
    and past the excitation's end with no sign of turning over -- genuine
    exponential divergence, not pulse dynamics. Killed manually; details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
2026-09-22 Fill in RF-Analysis-Plan.md section 9 (hypothesis results log)
    One row per H1-H8 per the task brief's section 7: pass/fail/open, the
    finding, and the run/script that produced it. H1/H3/H4/H7 pass at the
    circuit-model level (chain_model.py) but are unconfirmed by 3D. H5
    fails (Z0 54-56 ohm vs 50 target). H2 is open with wide sensitivity
    margin. H6/H8 are open -- Task E never produced a working 3D run.
2026-09-22 Housekeeping: track Next-Steps-Sonnet.md and step1_long_fine's summary.csv, ignore __pycache__
2026-09-22 RF analysis showed trace should be 0.36mm up from 0.32mm
2026-09-22 updated test trace as well
2026-09-28 Fab-ready layout cleanup and regenerated JLCPCB gerbers
    - J12 SWD header set DNP / excluded from BOM in schematic (alternative to J2
    Tag-Connect, only one fitted); DRU rule ignores their courtyard overlap
    - Ground and power pours: island removal set to Always (104 floating islands removed)
    - Removed 22 dangling tracks/vias; moved C50 GND via off its 0402 pad
    - Added GND vias at the RF chain and the D2/D4/D5 protection parts
    - Regenerated gerbers and drill files from the final board, plus
    telemetry-JLCPCB.zip for upload
    Zone-refilled DRC: 0 errors, 0 unconnected, 0 schematic parity (43 silkscreen
    warnings). Netlist match 163/163 parts, 581/581 pad nets.
2026-09-29 Regenerate silkscreen gerbers with soldermask subtracted
    The previous JLCPCB set clipped silkscreen off exposed pads (Subtract
    soldermask from silkscreen); ba7bfc5 was exported without it. Only the two
    silkscreen layers change; copper, mask, outline and drill are unchanged
    (copper files differed only in polygon emission order). Zip rebuilt.
2026-10-11 GNSS heading wiring per Quectel moving-base note; R10 73.2k
    Designer changes from 29 September (schematic, PCB, LC29HEAMD symbol):
    - Two LC29H(EA) wired for heading per the LC29H(EA) Moving Base Application
    Note: base U10 UART2 on pins 18/19 to rover U13 UART1 on pins 21/20
    (CORRECTION / HEADING), base pin 17 RESET_CTL to rover RESET_N
    (GNSS_RESET_SLAVE); reserved pins 5, 6, 15, 16 left unconnected and the
    four 39k D_SEL pull-ups removed
    - R10 changed to 73.2k so the TPS2121 IN1 overvoltage threshold sits above
    the PDM maximum; PCB footprint value synced to the schematic
    - Additional GND stitching vias; TXS0108EPWR library files added
    Verified 11 October 2026: schematic and PCB ag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
2026-10-23 Bring hardware docs and BOM in line with the netlist
    - Regenerate TELEMETRY_DigiKey_BOM.xlsx from telemetry.net: two LC29HEAMD
    modules, TXS0104EPW, two SD slots, antenna parts, R10 = 73.2k (TPS2121 OV1
    trip 15.8 to 17.2 V). All 159 designators match the netlist.
    - Rewrite hardware/README.md against the netlist (base and rover GNSS, two SD
    slots, correct connectors and power chain, MCU pin map).
    - Rewrite active_antenna_addition_BOM.md with current designators (J7/J8,
    U10 base, U13 rover), the moving-base wiring, and the ANN-MB5 choice
    (Quectel total active antenna gain limit is under 17 dB).
    - Fix stale labels in assets/architecture.svg and note that the power budget
    spreadsheet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
2026-10-23 Add Rust software: logic crates, host tools, SD adapters and diagrams
    Logic crates (no_std, forbid(unsafe_code), strict clippy):
    - tel-nmea: NMEA framing and parsing, PQTMTAR, PAIR/PQTM commands and the
    GNSS configure-and-verify sequencer
    - tel-can, tel-can-sbg, tel-can-motec: bounds-checked CAN signal engine and
    tables generated from sbgCan.dbc and a CSV signal list
    - tel-asm330, tel-tlc59108: IMU and LED drivers over embedded-hal 1.0
    - tel-logfmt: crash-safe append-only block log with CRC blocks, hints,
    sans-IO writer and recovery
    - tel-core: timer extension, PPS-disciplined UTC clock, IMU window, fusion
    into log samples, supervisor
    - tel-store: async storage driver over a BlockDev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
2026-10-23 Add assembly guide, bring-up self-test and logger firmware
    - hardware/ASSEMBLY.md: staged soldering guide with checks
    - tel-selftest: pass/fail rules for the bring-up test (27 tests)
    - firmware: bringup program, logger program, shared board code
    - diagrams and READMEs updated for the as-built design
    Not run on hardware yet.
